gastelumosiel/active-6-band-audio-equalizer-pcb/images/prototype/pcb_cnc_final_version.jpg

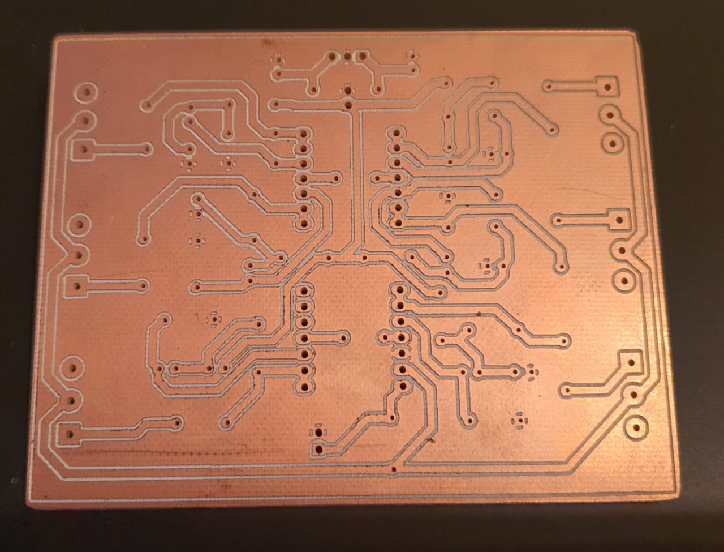
images/prototype/pcb_cnc_final_version.jpg
