gastelumosiel/active-6-band-audio-equalizer-pcb/images/prototype/pcb_cnc_3d_model.png

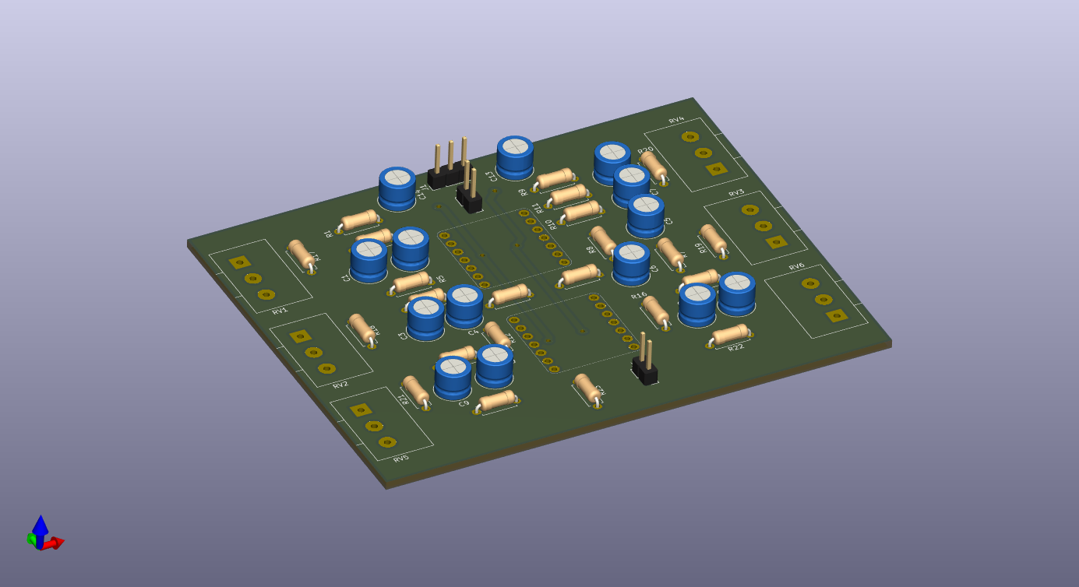
images/prototype/pcb_cnc_3d_model.png
