gastelumosiel/active-6-band-audio-equalizer-pcb/README.md

# active-6-band-audio-equalizer-pcb
Design, fabrication, and manufacturability analysis of a 4-layer PCB for a 6-band active audio equalizer using Sallen-Key filters and OPA4134 op-amps. Developed through an iterative approach from CNC-milled prototype to professional multilayer PCB in KiCad.
