gastelumosiel/active-6-band-audio-equalizer-pcb/prototype/results-report/Reporte_de_proyecto__Preamplificador_de_audio_activo.pdf

CENTRO DE ENSENANZA T ˜ | ECNICA Y SUPERIOR ´

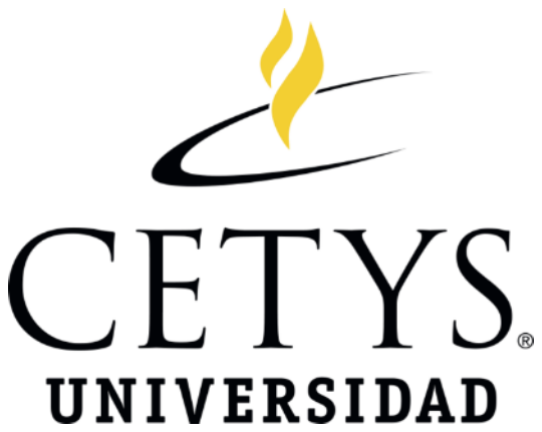
[picture p3: figure]

## Escuela de Ingeniería

Ingeniería en Cibernetica Electr ´ | onica ´
Diseno y fabricaci ˜ | on de circuitos integrados ´

## Reporte de proyecto: Preamplificador de audio activo de seis bandas

## Presentan: Osiel Gastelum Zazueta, 35596 ´ Rene Lozano García, 32827

## Tijuana, B.C., 20 de octubre de 2025

REPORTE DE AVANCE DE PROYECTO | 1

# Preamplificador de Audio Activo con Control de Seis Bandas

O. Gastelum Zazueta; R. Lozano Garcia ´

Resumen—En este trabajo se presenta el diseno y desarrollo ˜ de un preamplificador de audio activo basado en filtros de seis bandas de frecuencia. El sistema esta dise ´ nado para proporcionar ˜ control independiente sobre rangos de frecuencia específicos: pasa bajas (<60 Hz), y cuatro bandas intermedias (60-200 Hz, 200-600
Hz, 600-3 kHz, 3-12 kHz), ademas de un filtro pasa altas ( ´ | | >12
kHz). Se implementan topologías Sallen-Key de segundo orden con respuesta Butterworth para todas las bandas, utilizando
amplificadores operacionales de precision OPA4187. El dise ´ | | nõ
incluye una etapa de sumador amplificador con control individual de ganancia mediante potenciometros, seguido de un amplificador ´ inversor que funciona como control maestro de volumen. Se
presenta el proceso completo desde el diseno te ˜ | orico, simulaci ´ | on, ´
seleccion de componentes, hasta el dise ´ | no del circuito impreso ˜
(PCB), cumpliendo con las especificaciones de un area m ´ | axima ´
de 10cm x 10cm.

Index Terms—Preamplificador, filtros activos, Sallen-Key, Butterworth, ecualizador, amplificadores operacionales, PCB.

I. PROPUESTA DEL PROYECTO

I-A. Título
Preamplificador de Audio Activo con Control de Seis Bandas de Frecuencia

I-B. Introduccion´
E
l procesamiento de senales de audio ha sido fundamental ˜ en el desarrollo de sistemas de telecomunicaciones y entretenimiento desde sus inicios. Los ecualizadores y preamplificadores permiten manipular el contenido espectral de las senales de audio para mejorar su calidad, compensar ˜ deficiencias en la respuesta de transductores, o ajustar el sonido segun preferencias del usuario. ´
Los primeros dispositivos de ecualizacion eran sistemas ´ pasivos limitados que introducían perdidas significativas en ´
la senal. Con el desarrollo de la electr ˜ | onica de estado s ´ | olido ´
surgieron los ecualizadores activos, que incorporan amplificadores operacionales para no solo filtrar sino tambien amplificar ´ selectivamente las senales. Estos dispositivos han revoluciona- ˜ do la produccion musical, los sistemas de sonido profesional ´ y el audio de consumo.
Este proyecto se centra en el diseno e implementaci ˜ | on de un ´
preamplificador activo de seis bandas que divide el espectro audible en rangos específicos de frecuencia. El sistema permite control independiente de cada banda mediante potenciometros, ´ proporcionando flexibilidad para adaptar la respuesta de fre-
cuencia segun las necesidades de la aplicaci ´ | on. A trav ´ | es de ´
este desarrollo se exploran los fundamentos teoricos de los ´
filtros activos, los desafíos practicos del dise ´ | no de circuitos de ˜
audio, y la implementacion f ´ | ísica mediante un circuito impreso
profesional.

I-C. Planteamiento del Problema

En aplicaciones de audio profesional y de consumo, frecuentemente se requiere la capacidad de modificar selectivamente el contenido espectral de las senales de audio. Los sistemas ˜
de reproduccion, las caracter ´ | ísticas acusticas de los espacios, ´
y las preferencias individuales hacen necesario contar con herramientas que permitan ajustar la respuesta en frecuencia de manera controlada.
Los sistemas de ecualizacion pasiva introducen p ´ | erdidas ´
significativas y tienen limitaciones en cuanto a su capacidad de amplificacion. Por otro lado, los ecualizadores comerciales ´ pueden resultar costosos o no ofrecer la flexibilidad necesaria para aplicaciones específicas. Existe entonces la necesidad de desarrollar un sistema activo que proporcione control indepen-
diente sobre multiples bandas de frecuencia, dise ´ | no compacto ˜
y flexibilidad para ajuste en tiempo real.

I-D. Justificacion´

El desarrollo de este preamplificador activo se justifica por
multiples razones t ´ | ecnicas y educativas: ´
Aplicabilidad practica: ´ | El dispositivo puede ser utilizado
en sistemas de audio domesticos, estudios de grabaci ´ | on, sis- ´
temas de sonido en vivo, y aplicaciones de investigacion en ´ acustica. ´
Valor educativo: El proyecto integra conocimientos de
analisis de circuitos, procesamiento de se ´ | nales, dise ˜ | no de fil- ˜
tros activos, y fabricacion de PCB, proporcionando experiencia ´ practica en el ciclo completo de desarrollo de un producto ´ electronico. ´
Economía: El diseno propuesto utiliza componentes comer- ˜ ciales disponibles a costos accesibles, resultando en un sistema
considerablemente mas econ ´ | omico que equipos comerciales ´
equivalentes.
Flexibilidad: A diferencia de sistemas comerciales fijos, es-
te diseno permite modificaciones y ajustes seg ˜ | un necesidades ´
específicas, facilitando su adaptacion a diferentes aplicaciones. ´

I-E. Objetivo

Objetivo General: Disenar, implementar y validar un ˜ preamplificador de audio activo de seis bandas con control independiente de ganancia, utilizando filtros Sallen-Key de segundo orden y amplificadores operacionales de precision. ´ Objetivos Específicos:
Disenar filtros activos Sallen-Key con respuesta Butter- ˜ worth para cada una de las seis bandas de frecuencia especificadas

Calcular y seleccionar los valores de componentes pasivos (resistores y capacitores) para lograr las frecuencias de corte deseadas
Implementar una etapa de sumador amplificador con control individual de ganancia para cada banda Seleccionar componentes apropiados considerando tolerancias, disponibilidad y encapsulados through-hole Desarrollar el esquematico el ´ ectrico completo del sistema ´ Disenar el circuito impreso (PCB) cumpliendo con las ˜ restricciones dimensionales establecidas
Generar los archivos Gerber y de perforacion necesarios ´ para la fabricacion´
Realizar un prototipado rapido como demostraci ´ | on del ´
anteproyecto

I-F. Marco teorico ´
I-F1. Filtros Activos: Segun Alexander y Sadiku [1], ´
un filtro es un circuito electrico cuya funci ´ | on principal es ´
la modificacion o manipulaci ´ | on del espectro en frecuencias ´
de una senal de entrada. Los filtros activos, a diferencia ˜ de sus contrapartes pasivas, utilizan elementos activos como amplificadores operacionales junto con componentes pasivos, permitiendo no solo el filtrado selectivo de frecuencias sino
tambien la amplificaci ´ | on de la se ´ | nal. ˜
Como mencionan Dorf y Svoboda [2], estos circuitos tienen
la capacidad de eliminar de una senal el ˜ | ectrica elementos no ´
deseados como el ruido electrico, adem ´ | as de proporcionar ´
ganancia sin las perdidas inherentes a los filtros pasivos. El ´
termino respuesta en frecuencia describe c ´ | omo un circuito ´
particular afecta a la senal que pasa a trav ˜ | es de ´ | el, ya sea ´
amplificando o atenuando frecuencias específicas.
Los filtros activos presentan ventajas significativas sobre los pasivos:
Capacidad de amplificacion de la se ´ | nal ˜
Alta impedancia de entrada
Baja impedancia de salida
No requieren inductores (componentes voluminosos y costosos)
Mayor flexibilidad en el disenõ
Mejor control sobre la respuesta en frecuencia
I-F2. Topología Sallen-Key: La topología Sallen-Key, tambien conocida como fuente de voltaje controlada por volta- ´ je (VCVS), es una de las configuraciones mas populares para ´ implementar filtros activos de segundo orden. Esta topología, desarrollada por R.P. Sallen y E.L. Key en 1955 [11], ofrece varias ventajas:
Requiere solo un amplificador operacional por seccion´ de segundo orden
Utiliza unicamente capacitores y resistores como elemen- ´ tos pasivos
Proporciona baja impedancia de salida
Permite implementar diferentes tipos de respuesta (Butterworth, Bessel, Chebyshev)
Facilita el diseno en cascada para ˜ | ordenes superiores ´
I-F3. Respuesta Butterworth: Segun Torres De Roa [6], ´ el filtro Butterworth ofrece el mejor termino medio entre ´ la atenuacion y la respuesta en fase, proporcionando una ´ transicion suave entre la banda pasante y la banda de rechazo. ´ Su característica principal es una respuesta maximamente ´ plana en la banda util, garantizando que no haya ondulaciones ´ que distorsionen la senal. ˜
Para aplicaciones de audio, la respuesta Butterworth es particularmente adecuada porque:

Minimiza la distorsion de fase en la banda pasante ´ Proporciona una transicion predecible entre bandas ´ Ofrece características de fase superiores comparadas con Chebyshev
Resulta en un sonido mas natural sin coloraci ´ | on excesiva ´
I-F4. Amplificadores Operacionales de Precision: ´ | El
OPA4187 es un amplificador operacional de precision que ´ ofrece bajo ruido, bajo offset y alta velocidad de slew rate, características esenciales para aplicaciones de audio de alta calidad [9]. Con cuatro amplificadores por circuito integrado,
proporciona una solucion compacta y econ ´ | omica para el ´
diseno propuesto. ˜

I-G. Metodología

El desarrollo del proyecto sigue una metodología estructura-
da que abarca desde el diseno te ˜ | orico hasta la implementaci ´ | on´
física:
I-G1. Fase 1: Diseno Te ˜ | orico y Simulaci ´ | on: ´
1. Especificacion de requisitos: ´
Definicion de bandas de frecuencia ´ Especificacion de orden de filtros ´
Seleccion de tipo de respuesta (Butterworth) ´ Definicion de rangos de ganancia ´
2. Calculo de componentes: ´
Utilizacion de herramienta de dise ´ | no de filtros de ˜
Texas Instruments (WEBENCH Filter Designer) Seleccion de valores comerciales de la serie E96 ´ (resistores 1 %) y E12 (capacitores 10 %)
I-G2. Fase 2: Diseno Electr ˜ | | onico: ´
1. Desarrollo del esquematico: ´
Diagramacion completa del circuito en KiCAD ´ Inclusion de todos los componentes y conexiones ´ Asignacion de valores y referencias ´
Verificacion de conectividad mediante DRC (De- ´ sign Rule Check)
2. Seleccion de componentes: ´
Identificacion | de | footprints | espec ´ | íficos | para
through-hole
Descarga de footprints y modelos 3D
Justificacion t ´ | ecnica de cada selecci ´ | on basada en ´
hojas de datos
3. Lista de materiales (BOM):
Compilacion de todos los componentes ´
Especificacion de n ´ | umeros de parte ´
Cantidades requeridas
Descripcion t ´ ecnica de cada componente ´

I-G3. Fase 3: Diseno del PCB: ˜
1. Layout del PCB:
Colocacion estrat ´ | egica de componentes ´
Ruteo de pistas considerando:
- Minimizacion de ruido e interferencias ´
- Separacion de se ´ | nales anal ˜ | ogicas y digitales ´
- Longitud de pistas críticas
- Ancho de pistas segun corriente ´ Implementacion de planos de tierra ´
Ubicacion de puntos de montaje ´
2. Verificacion del dise ´ | no: ˜
Verificacion de reglas de dise ´ | | no (DRC) ˜
Verificacion el ´ | ectrica (ERC) ´
Revision dimensional ( ´ | | ≤ 100 mm x 100 mm)
Verificacion de clearances y espaciamientos ´
3. Generacion de archivos de fabricaci ´ | on: ´
Archivos Gerber
Archivos de perforacion´
Dibujo de fabricacion con notas especiales ´
Exportacion del esquem ´ | atico en PDF ´

II. DISENÕ ELECTRICO ´

II-A. Arquitectura General del Sistema
El preamplificador propuesto consta de dos etapas principales:
1. Etapa de filtrado: Seis filtros activos independientes que dividen la senal de entrada en las bandas especifi- ˜ cadas
2. Etapa de sumador amplificador: Combina las senales ˜ filtradas con control de ganancia individual para cada banda

II-B. Especificaciones de las Bandas de Frecuencia
La Tabla I presenta las especificaciones completas de cada banda, incluyendo el tipo de filtro, rango de frecuencia, considerando que todos son de topología Sallen-Key, de segundo orden y con una respuesta Butterworth.

Cuadro I
ESPECIFICACIONES DE BANDAS DE FRECUENCIA
Banda | Tipo | Rango
1 | Pasa bajas | < 60 Hz
2 | Pasa bandas | 60-200 Hz
3 | Pasa bandas | 200-600 Hz
4 | Pasa bandas | 600-3k Hz
5 | Pasa bandas | 3-12k Hz
6 | Pasa altas | > 12 kHz

II-C. Diseno de Filtros Sallen-Key ˜
Para el diseno de los filtros activos se utiliz ˜ | o la herramienta ´
WEBENCH Filter Designer de Texas Instruments [10]. Esta
herramienta permite el calculo autom ´ | atico de valores de com- ´
ponentes para filtros Sallen-Key con respuesta Butterworth, considerando las especificaciones de frecuencias de corte y factor de calidad Q requeridos. Los valores finales de componentes se presentan a continuacion basados en el archivo ´ Excel proporcionado.
El filtro pasa bajas de segundo orden se implementa mediante la configuracion Sallen-Key con frecuencia de corte de 60 ´ Hz y factor de calidad Q = 0.707 (característico de respuesta Butterworth de segundo orden).
Los filtros pasa bandas se disenaron especificando las ˜ frecuencias de corte inferior y superior para cada banda. La herramienta calcula automaticamente la frecuencia central ´ fc =

√
fL · fH y el factor de calidad Q =

fc
BW necesarios
para la implementacion Sallen-Key. ´
El filtro pasa altas de segundo orden utiliza frecuencia de corte de 12 kHz con Q = 0.707.

II-D. Etapa de Sumador Amplificador
La etapa sumadora combina las seis senales filtradas me- ˜ diante un amplificador operacional en configuracion de su- ´ mador inversor. Para proporcionar control individual de cada
banda, se utilizan potenciometros de 20 k ´ | | | Ω como resistencias
de entrada para cada canal, con un resistor de 1 kΩ en serie como limitador.
Con los valores de cada fase específicados en la tabla II, la ganancia por banda es ajustable, proporcionando un rango de control adecuado para aplicaciones de audio.

II-E. Seleccion de Componentes ´
II-E1. Amplificadores Operacionales: Se selecciono el ´ OPA4187 de Texas Instruments como amplificador operacional principal [9]:
Justificacion t ´ ecnica: ´
Bajo ruido: 3.2 nV/√
Hz @ 1 kHz (crítico para audio) Alto CMRR: 120 dB típico
Bajo offset: ±25 µV maximo ´
Ancho de banda: 15 MHz (suficiente para audio)
Slew rate: 8 V/µs (adecuado para senales de audio) ˜ Cuatro amplificadores por IC (economía y compacidad) Alimentacion: ±2.25 V a ±18 V ´
Cantidad requerida:
6 filtros (6 amplificadores)
1 sumador (1 amplificador)
Total: 7 amplificadores = 2 IC OPA4187
II-E2. Resistores: Especificacion: ´ Serie E96, tolerancia
1 %, potencia 1/4 W, montaje through-hole (THT), footprint
R_Axial_DIN0207_L6.3mm_D2.5mm_P7.62mm_Horizontal
II-E3. Capacitores: Especificacion: ´ | Serie E12, tolerancia
10 %, tipo ceramico/radial, ´ | montaje through-hole (THT),
footprint C_Radial_D6.3mm_H5.0mm_P2.50mm
II-E4. Potenciometros: ´ | Especificacion: ´ | Tipo vertical para
PCB, 20 kΩ, lineal (tipo B)
Cantidad requerida:
6 potenciometros para control individual de bandas ´
Total: 6 potenciometros de 20 k ´ | Ω
II-E5. Conectores: Entrada de senal: ˜ | Conector Jack 3.5
mm mono o estereo (selecci ´ | on seg ´ | un aplicaci ´ | on) ´
Salida de senal: ˜ | Conector Jack 3.5 mm mono o estereo ´
Alimentacion: ´ | Conector de 3 pines para fuente dual (V+,
GND, V-)

II-F. Lista de Materiales

La Tabla II presenta la lista completa de materiales (BOM) con símbolos correspondientes al diagrama esquematico. ´

Cuadro II
LISTA DE MATERIALES (BOM)
Símbolo | Descripcion´ | Cantidad
| Pasa Bajas (Banda 1)
R1 | Resistor 1.3 k, 1 %, 1/4W, THT | 1
R2 | Resistor 2.49 k, 1 %, 1/4W, THT | 1
C1 | Capacitor 1 F, radial, THT | 1
C2 | Capacitor 2.2 F, radial, THT | 1
| Pasa Bandas 1 (Banda 2)
R3 | Resistor 11.3 k, 1 %, 1/4W, THT | 1
R4 | Resistor 205 , 1 %, 1/4W, THT | 1
R5 | Resistor 1.05 M, 1 %, 1/4W, THT | 1
C3 | Capacitor 100 nF, radial, THT | 1
C4 | Capacitor 100 nF, radial, THT | 1
| Pasa Bandas 2 (Banda 3)
R6 | Resistor 4.02 k, 1 %, 1/4W, THT | 1
R7 | Resistor 66.5 , 1 %, 1/4W, THT | 1
R8 | Resistor 324 k, 1 %, 1/4W, THT | 1
C5 | Capacitor 100 nF, radial, THT | 1
C6 | Capacitor 100 nF, radial, THT | 1
| Pasa Bandas 3 (Banda 4)
R9 | Resistor 6.65 k, 1 %, 1/4W, THT | 1
R10 | Resistor 169 , 1 %, 1/4W, THT | 1
R11 | Resistor 845 k, 1 %, 1/4W, THT | 1
C7 | Capacitor 10 nF, radial, THT | 1
C8 | Capacitor 10 nF, radial, THT | 1
| Pasa Bandas 4 (Banda 5)
R12 | Resistor 1.78 k, 1 %, 1/4W, THT | 1
R13 | Resistor 37.4 k, 1 %, 1/4W, THT | 1
R14 | Resistor 191 k, 1 %, 1/4W, THT | 1
C9 | Capacitor 10 nF, radial, THT | 1
C10 | Capacitor 10 nF, radial, THT | 1
| Pasa Altas (Banda 6)
R15 | Resistor 13.3 k, 1 %, 1/4W, THT | 1
R16 | Resistor 6.49 k, 1 %, 1/4W, THT | 1
C11 | Capacitor 1.8 nF, radial, THT | 1
C12 | Capacitor 1.2 nF, radial, THT | 1
| Amplificador Sumador
RV1-RV6 | Potenciometro 20 k lineal ´ | 6
R17-R22 | Resistor 1 k, 1 %, 1/4W, THT | 6
R23 | Resistor realimentacion sumador ´ | 1
| Componentes Activos
U1, U2 | IC Op-Amp OPA4187 | 2
III. DISENO DEL ˜ | CIRCUITO IMPRESO (PCB)

III-A. Consideraciones de Disenõ

El diseno del PCB para un preamplificador de audio requiere ˜ consideraciones especiales para minimizar ruido, interferencias y distorsion: ´
III-A1. Estrategia de Layout:
Separacion de etapas: ´ | Las seis bandas de filtrado se
organizan en dos grupos paralelos para optimizar el espacio
Flujo de senal: ˜ Layout disenado siguiendo el flujo ˜ natural de la senal desde la entrada, pasando por los ˜ filtros, el sumador y finalmente el amplificador maestro hasta la salida

Plano de tierra: Implementacion de plano de tierra ´ continuo en la capa inferior para minimizar impedancia y proporcionar blindaje
III-A2. Ruteo de Pistas:
Ancho de pistas: 1 mm (suficiente para senales de audio ˜ de bajo nivel)
Clearance mínimo: 0.254 mm
Longitud de pistas críticas: Minimizada entre entrada de amplificadores operacionales y componentes pasivos Pistas de entrada/salida: Alejadas de pistas de alimentacion para minimizar acoplamiento capacitivo ´
III-A3. Ubicacion de Componentes: ´
Capacitores de desacoplo: Ubicados lo mas cerca po- ´ sible de los pines de alimentacion´
Componentes de filtro: Agrupados por banda para minimizar longitud de interconexiones
Potenciometros: ´ | Ubicados en el borde del PCB para
facilitar acceso y manipulacion´
Conectores: Posicionados en bordes opuestos (entrada en un lado, salida en otro) para evitar acoplamiento
III-A4. Tecnicas de Reducci ´ | on de Ruido: ´
Estrellado de tierras: Punto de conexion´ | unico para ´
todas las tierras analogicas ´
Zonas de tierra: Pistas de tierra rodeando senales cr ˜ | íti-
cas

III-B. Especificaciones del PCB
Dimensiones: Dentro del límite de 10 cm × 10 cm
Numero de capas: ´ | 2 capas (superior: componentes y
senal, inferior: pistas de alimentaci ˜ | on y tierra) ´
Espesor del PCB: 1.6 mm (estandar) ´
Serigrafía: Blanca en capa superior (referencias de componentes, logos, informacion) ´
Material: FR-4 (estandar) ´
Espesor del cobre: 1 oz (35 µm)
III-C. Esquematico El ´ | ectrico ´

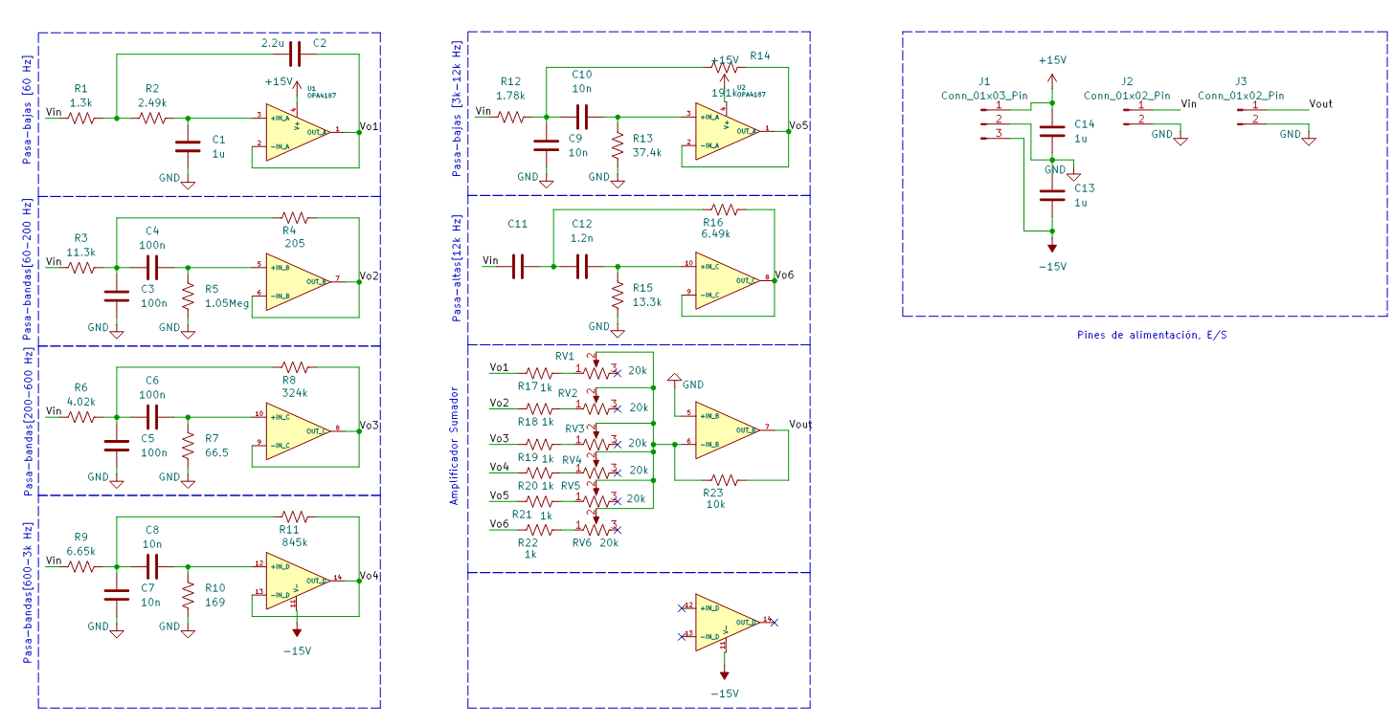
[picture p4: figure]

Figura 1. Esquematico el ´ | ectrico completo del preamplificador de audio activo. ´
Se muestran las seis etapas de filtrado, la etapa sumadora y la etapa maestra de amplificacion. ´

El esquematico completo del circuito se presenta en la ´ Figura 1. El diagrama incluye todas las conexiones electri- ´ cas, valores de componentes actualizados segun el Excel, y ´ referencias necesarias para la implementacion del circuito. ´

III-D. Layout del PCB

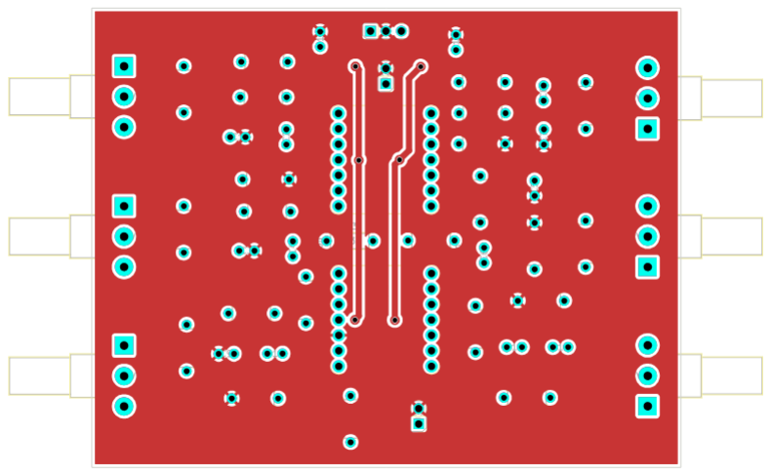
[picture p5: figure]

Figura 2. Vista de la capa superior del PCB mostrando el ruteo de senales, ˜
ubicacion de componentes THT, y colocaci ´ | on de potenci ´ | ometros y conectores. ´

III-D1. Capa Superior (Top Layer): La Figura 2 muestra la capa superior del PCB donde se ubican todos los componentes through-hole y la mayoría del ruteo de senales. Se puede ˜ observar:
Distribucion sim ´ | etrica de las seis etapas de filtrado ´
Ubicacion estrat ´ | egica de los potenci ´ | ometros en el borde ´
superior para facil acceso ´
Conectores de entrada y salida en bordes opuestos Capacitores de desacoplo cercanos a cada IC Serigrafía con referencias de componentes

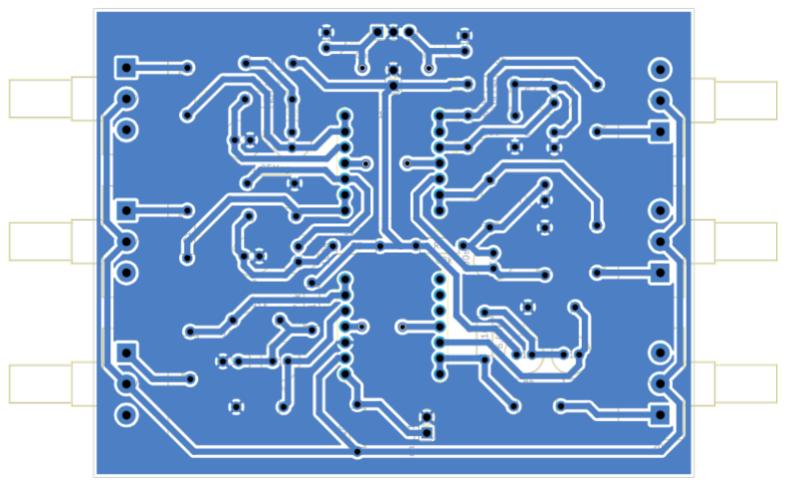
[picture p6: figure]

Figura 3. Vista de la capa inferior del PCB mostrando el plano de tierra continuo y conexiones de alimentacion. ´

III-D2. Capa Inferior (Bottom Layer): La capa inferior (Figura 3) esta mayormente dedicada al plano de tierra, ´ proporcionando:
Referencia comun de baja impedancia para todas las ´ senales ˜
Blindaje contra interferencias electromagneticas ´
Camino de retorno de corriente optimo ´
Distribucion eficiente de alimentaci ´ | on´
III-D3. Vista 3D del PCB: El modelo 3D (Figura 4) proporciona una visualizacion realista del producto final, per- ´ mitiendo verificar:

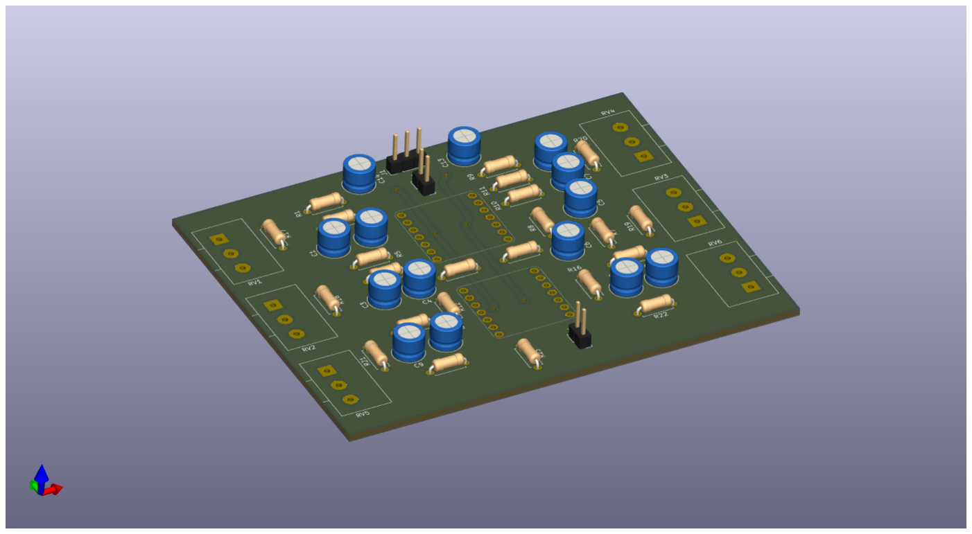
[picture p7: figure]

Figura 4. Modelo 3D del PCB ensamblado mostrando componentes THT, potenciometros y conectores. ´

Altura total del ensamble con componentes through-hole Interferencias mecanicas potenciales ´
Accesibilidad de controles
Aspecto estetico del dise ´ | nõ
III-E. Verificacion del Dise ´ | nõ

III-E1. Design Rule Check (DRC):
Verificacion de espaciamientos m ´ | | ínimos entre pistas
Verificacion de ancho m ´ | | ínimo de pistas
Verificacion de tama ´ | no de v ˜ | ías y perforaciones para
componentes THT
Verificacion de zonas de cobre y clearances ´
Resultado: 0 errores, 0 advertencias

III-E2. Electrical Rule Check (ERC):
Verificacion de conectividad el ´ | | ectrica ´
Deteccion de nodos flotantes ´
Verificacion de alimentaci ´ | on de todos los componentes ´
Deteccion de cortocircuitos ´
Resultado: 0 errores, advertencias menores resueltas

III-E3. Verificacion Dimensional: ´
Area total: ´ | < 100 cm²
Clearance a bordes
Ubicacion de perforaciones de montaje ´
Espacio suficiente para componentes through-hole (altura adecuada)
III-F. Generacion de Archivos de Fabricaci ´ | on´

III-F1. Archivos Gerber (RS-274X): Los siguientes archi-
vos Gerber fueron generados segun el formato est ´ | andar RS- ´
274X [13]:

PCB_ProyectoParte_1-F_Cu.gbr: Capa superior
de cobre
PCB_ProyectoParte_1-B_Cu.gbr: Capa inferior
de cobre (plano de tierra)
PCB_ProyectoParte_1-B_SilkS.gbr: Serigrafía
inferior
PCB_ProyectoParte_1-Edge_Cuts.gbr: Con-
torno del PCB

III-F2. Archivos de Perforacion (Excellon): ´

PCB_ProyectoParte_1.drl: Archivo de perfora-
ciones
Especificaciones de perforacion: ´
Perforaciones de componentes THT (resistores, capacitores): 0.8-1.0 mm
Perforaciones de potenciometros: 1.0-1.2 mm ´ Perforaciones de conectores: segun especificaciones del ´ fabricante

IV. RESULTADOS PRELIMINARES

IV-A. Simulacion del Dise ´ | nõ
Aunque la simulacion completa del circuito est ´ | a pendiente ´
de realizarse con el software apropiado (LTspice o similar), se han verificado los siguientes aspectos teoricos: ´
IV-A1. Respuesta en Frecuencia Calculada: Para cada banda, se verificaron las frecuencias de corte teoricas basadas ´ en los valores de componentes del Excel:

Cuadro III
BANDAS DE FRECUENCIA CON VALORES ACTUALIZADOS
Banda | Tipo | Rango objetivo
1 | Pasa bajas | <60 Hz
2 | Pasa bandas | 60-200 Hz
3 | Pasa bandas | 200-600 Hz
4 | Pasa bandas | 600-3k Hz
5 | Pasa bandas | 3-12k Hz
6 | Pasa altas | >12k Hz
IV-A2. Analisis de Tolerancias: ´ | Considerando el peor caso
(worst-case analysis) con tolerancias de componentes: Resistores: ±1 %
Capacitores: ±10 %
Variacion total esperada en ´ | fc: Aproximadamente
±11 %
Esta variacion es aceptable para aplicaciones de audio, ´ donde las bandas adyacentes proporcionan cobertura de solapamiento.
IV-A3. Analisis de Ganancia: ´ | Para la etapa de sumador
con potenciometros de 20 k ´ | Ω, el rango de ganancia por banda
es ajustable segun los valores de resistores de realimentaci ´ | on´
implementados.
IV-B. Verificacion del Dise ´ | no del PCB ˜
IV-B1. Analisis de Integridad de Se ´ | nal: ˜ | Se verificaron
manualmente los siguientes aspectos:
Longitud de pistas críticas: Todas las pistas entre entradas de op-amps y componentes pasivos minimizadas Acoplamiento de pistas: Separacion adecuada entre ´ pistas paralelas de senal ˜
Loops de tierra: Minimizados mediante plano de tierra continuo
Retorno de corriente: Plano de tierra proporciona camino de baja impedancia

IV-B2. Fresado: El primer intento de fresado de la placa fenolica fue un proceso bastante ilustrativo del funcionamiento ´ de los sistemas que controlan las brocas y su posicion en los ´ ejes X, Y, y Z. En los trazos hechos por la broca de grabado en figura V, fue posible observar un ligero desacuerdo entre la vision original y el resultado del archivo G-Code. ´

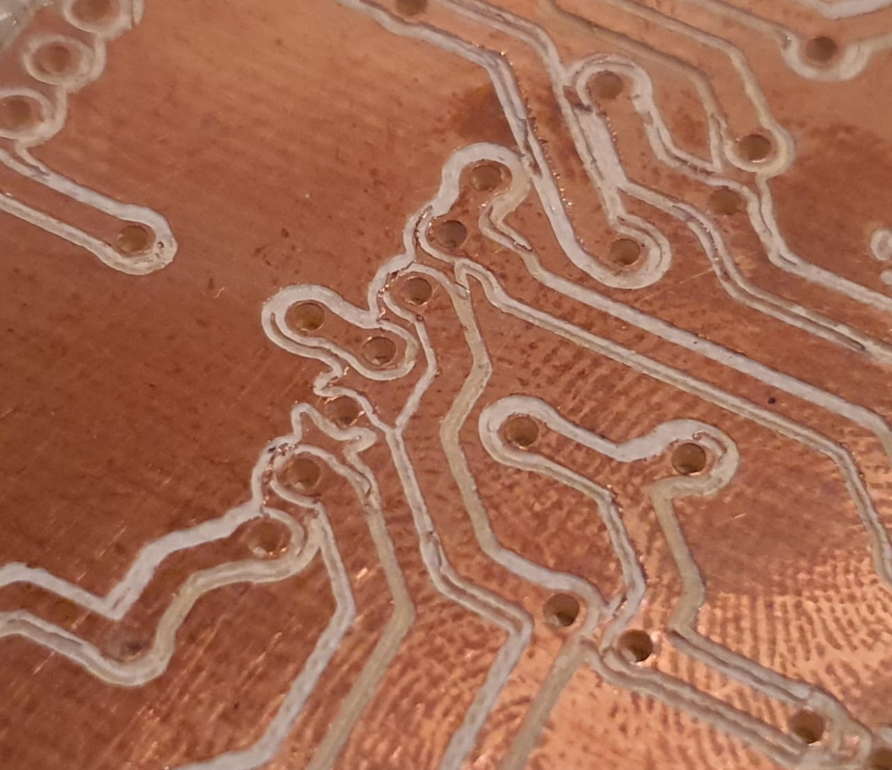
[picture p8: figure]

Figura 5. Primer intento de fresado, con errores en el codigo. ´

Al observar este resultado, se tomo un mayor cuidado en ´ el procedimiento de generacion de archivos, partiendo de ´ los Gerber en FlatCAM. Se realizaron modificaciones a las configuraciones para realizar un mejor trabajo en el siguiente intento.


Figura 6. Circuito impreso en su version final ´

IV-C. Archivos Generados

El proyecto completo en KiCAD incluye los siguientes archivos principales:

1. PCB_ProyectoParte_1.kicad_pro: Archivo de
proyecto
2. PCB_ProyectoParte_1.kicad_sch: Esquemati- ´
co electrico ´
3. PCB_ProyectoParte_1.kicad_pcb: Layout del
PCB
4. Carpeta gerber/: Archivos Gerber y de perforacion´
5. PCB_ProyectoParte_1_fabrication_drawing.pdf:
Dibujo de fabricacion´
6. PCB_ProyectoParte_1_schematic.pdf:
Esquematico en PDF ´
Todos los archivos estan organizados y comprimidos en ´ formato ZIP para entrega.
V. CONCLUSIONES
En este trabajo se ha completado exitosamente el disenõ completo de un preamplificador de audio activo de seis bandas, cumpliendo con todos los objetivos establecidos para esta fase del proyecto.

V-A. Logros del Avance
1. Diseno te ˜ | orico completo: ´ | Se disenaron todos los filtros ˜
para las seis bandas de frecuencia utilizando valores de componentes through-hole especificados, garantizando respuesta Butterworth y frecuencias de corte precisas.
2. Seleccion de componentes: ´ | Se identificaron y espe-
cificaron todos los componentes necesarios en version through-hole, incluyendo footprints apropiados ´
(R_Axial_DIN0207 y C_Radial_D6.3mm) y jus-
tificacion t ´ | ecnica basada en hojas de datos. ´
3. Esquematico el ´ | ectrico: ´ | Se desarrollo el diagrama ´
electrico completo en KiCAD, verificado mediante DRC ´ y ERC sin errores.
4. Diseno del PCB: ˜ | Se completo el layout del circuito ´
impreso cumpliendo con las restricciones dimensionales y aplicando las mejores practicas para circuitos de audio ´ con componentes THT.
5. Documentacion de fabricaci ´ | on: ´ | Se generaron todos
los archivos necesarios para la fabricacion profesional ´ del PCB, incluyendo archivos Gerber, archivos de per-
foracion y dibujo de fabricaci ´ | on con especificaciones ´
completas.

V-B. Analisis de Viabilidad ´
El diseno propuesto es t ˜ | ecnicamente viable y presenta las ´
siguientes fortalezas:
Componentes disponibles: Todos los componentes THT especificados estan disponibles comercialmente de pro- ´ veedores como Digi-Key, Mouser y otros distribuidores autorizados.
Fabricacion est ´ | andar: ´ | El PCB utiliza especificaciones
estandar de la industria (2 capas, FR-4) compatible con ´
servicios de fabricacion econ ´ | omicos (JLCPCB, PCBWay, ´
etc.).
Facilidad de ensamble: Los componentes through-hole facilitan el proceso de soldadura manual y permiten inspeccion visual directa de las conexiones. ´

V-C. Trabajo Futuro
Para la segunda fase del proyecto (implementacion y prue- ´ bas), se planean las siguientes actividades:
1. Simulacion completa: ´
Analisis AC de cada banda en LTspice ´
Analisis de transitorios ´
Analisis de distorsi ´ | on arm ´ | onica (THD) ´
Analisis de ruido ´
2. Fabricacion del PCB: ´
Seleccion del fabricante ´
Cambio de diseno a componentes SMT ˜ Envío de archivos Gerber
Recepcion y verificaci ´ | on de PCBs ´
3. Adquisicion de componentes: ´
Generacion de orden de compra ´ Compra de componentes through-hole Inspeccion al recibir ´
4. Ensamble:
Soldadura de componentes SMT
Inspeccion visual y el ´ | ectrica ´
5. Pruebas y caracterizacion: ´
Pruebas de continuidad
Verificacion de alimentaci ´ | | on´
Medicion de respuesta en frecuencia ´
Medicion de ganancia y rango de control ´ Documentacion de resultados ´
El proyecto esta bien encaminado para su conclusi ´ | on exitosa ´
en la segunda fase, con expectativas realistas de obtener un producto funcional que cumpla con las especificaciones de diseno. ˜

REFERENCIAS

[1] C. K. Alexander and M. N. O. Sadiku, Fundamentos de Circuitos
Electricos ´ | , 5ta ed. McGraw-Hill, 2013.
[2] R. C. Dorf y J. A. Svoboda, Circuitos Electricos ´ | , Alfaomega, 2011.
[3] J. Fraile, Circuitos Electricos ´ | , Pearson, 2012.
[4] W. Hayt, J. Kemmerly, J. Phillips y S. Durbin, Analisis de Circuitos en ´ Ingeniería, 9na ed., McGraw Hill, 2019.
[5] J. M. Fiore, Operational Amplifiers & Linear Integrated Circuits: Theory and Application, 3rd ed., Dissidents, 2024.
[6] L. D. Torres De Roa, Realizacion Activa en Matlab ´ | , Universidad de las
Americas Puebla, 2007. ´
[7] D. Madrid, Implementacion de Filtros Pasa Baja: Bessel y Chebyshev ´ | ,
ResearchGate, 2017.
[8] Universidad Nacional de Tucuman, ´ Filtros, 2017. Disponible en: https: //catedras.facet.unt.edu.ar/e1/
[9] Texas Instruments, OPA4187 36-V, Precision, Low-Noise, Rail-to-Rail Output, JFET Operational Amplifier, Datasheet, 2021.
[10] Texas Instruments, WEBENCH Filter Designer, 2024. Disponible
en: | https://www.ti.com/design-resources/design-tools-simulation/
webench-power-designer.html (https://www.ti.com/design-resources/design-tools-simulation/webench-power-designer.html)
[11] R. P. Sallen and E. L. Key, A Practical Method of Designing RC Active Filters, IRE Transactions on Circuit Theory, vol. CT-2, pp. 74-85, 1955.
[12] KiCAD EDA, KiCAD Documentation, Version 9.0, 2024. Disponible en: https://docs.kicad.org/
[13] IPC, IPC-2221B: Generic Standard on Printed Board Design, IPC International, 2012.
