gastelumosiel/active-6-band-audio-equalizer-pcb/docs/BOM.xlsx

Sheet: BOM
 |  |  |  |  |  |  |  |  |  |  | No de PCBs | 2
Bloque de alimentación |  | BOM
 |  | Componente | Valor | Rating | Tipo de montura | Footprint | Referencia | Digikey Num | Datasheets | Precio c/u | Cantidad (uni) | P. Comp. | Subtotal (2) | P. EXT
 |  | Charge pump regulator |  |  | SMT |  | TC962COE | TC962COE-ND | Link (https://ww1.microchip.com/downloads/aemDocuments/documents/APID/ProductDocuments/DataSheets/21484D.pdf) | $3.92 | 1 | $3.92 | 2 | $7.84
 |  | Barrel DC |  |  | SMT |  | PJ-114AH-SMT-TR | 2223-PJ-114AH-SMT-TRCT-ND | Link (https://www.kycon.com/Pub_Eng_Draw/KLDVX-SMT-02-B.pdf) | $0.84 | 1 | $0.84 | 2 | $1.68
 |  | Regulador 15 V |  | 15 V, 1.5 A | SMT |  | L7815CD2T-TR | 497-1179-1-ND | Link (https://www.st.com/content/ccc/resource/technical/document/datasheet/41/4f/b3/b0/12/d4/47/88/CD00000444.pdf/files/CD00000444.pdf/jcr:content/translations/en.C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) | $0.90 | 1 | $0.90 | 2 | $1.80
 |  | CA1 | 0.33 uF | 5%, 50 V | SMT | 0805 | C0805C334J5RECAUTO | 399-C0805C334J5RECAUTOCT-ND |  | $0.28 | 1 | $0.28 | 2 | $0.56
 |  | CA2 | 0.1 uF | 5%, 50V | SMT | 0805 | C0805C104J5RACTU | 399-C0805C104J5RACTUCT-ND | Link (https://www.yageogroup.com/content/datasheet/asset/file/KEM_C1002_X7R_SMD) | $0.15 | 1 | $0.15 | 2 | $0.30
 |  | CA3 a CA4 | 10 uF | 10%, 20 V | SMT | 1206 (3216 Metric) | T491A106K020AT | 399-18019-1-ND | Link (https://www.yageogroup.com/content/datasheet/asset/file/KEM_T2004_T490) | $0.60 | 2 | $1.20 | 3 | $1.80
 |  | CA5 | 1 uF | 10%, 20 V | SMT | 1206 (3216 Metric) | TPSA105K020R3000 | 478-2399-1-ND | Link (https://datasheets.kyocera-avx.com/TPS.pdf) | $0.63 | 1 | $0.63 | 2 | $1.26
Bloque de señal de entrada |  | Jack Mono 3.5 mm |  |  | SMT |  | MJ-3523-SMT-TR | CP-3523MJCT-ND | Link (https://www.sameskydevices.com/product/resource/mj-3523-smt.pdf) | $0.92 | 2 | $1.84 | 3 | $2.76
Bloque de preamplificación | Pasa bajas | R1 | 1.3 kΩ | 1%, 0.125W | SMT | 0805 | RMCF0805FT1K30 | RMCF0805FT1K30CT-ND | Link (https://www.seielect.com/catalog/SEI-RMCF_RMCP.pdf) | $0.10 | 1 | $0.10 | 3 | $0.30
 |  | R2 | 2.49 kΩ | 1%, 0.125W | SMT | 0805 | RC0805FR-072K49L | 311-2.49KCRCT-ND | Link (https://www.yageogroup.com/content/datasheet/asset/file/PYU-RC_GROUP_51_ROHS_L) | $0.10 | 1 | $0.10 | 3 | $0.30
 |  | C1 | 1 uF | 5%, 50V | SMT | 0805 | CC0805JKX7R9BB105 | 311-3498-1-ND | Link (https://www.yageogroup.com/content/datasheet/asset/file/UPY-GPHC_X7R_6_3V-TO-250V) | $0.29 | 1 | $0.29 | 2 | $0.58
 |  | C2 | 2.2 uF | 5%, 25V | SMT | 0805 | CC0805JKX7R8BB225 | 13-CC0805JKX7R8BB225CT-ND | Link (https://www.yageogroup.com/content/datasheet/asset/file/UPY-GPHC_X7R_6_3V-TO-250V) | $0.25 | 1 | $0.25 | 2 | $0.50
 | Pasa bandas 1 | R3 | 11.3 kΩ | 1%, 0.125W | SMT | 0805 | RC0805FR-0711K3L | 311-11.3KCRCT-ND | Link (https://www.yageogroup.com/content/datasheet/asset/file/PYU-RC_GROUP_51_ROHS_L) | $0.10 | 1 | $0.10 | 3 | $0.30
 |  | R4 | 205 Ω | 1%, 0.125W | SMT | 0805 | RC0805FR-07205RL | 311-205CRCT-ND | Link (https://www.yageogroup.com/content/datasheet/asset/file/PYU-RC_GROUP_51_ROHS_L) | $0.10 | 1 | $0.10 | 3 | $0.30
 |  | R5 | 1.05 MΩ | 1%, 0.125W | SMT | 0805 | RC0805FR-071M05L | 311-1.05MCRCT-ND | Link (https://www.yageogroup.com/content/datasheet/asset/file/PYU-RC_GROUP_51_ROHS_L) | $0.10 | 1 | $0.10 | 3 | $0.30
 |  | C3 a C4 | 100 nF | 5%, 50V | SMT | 805 | C0805C104J5RACTU | 399-C0805C104J5RACTUCT-ND | Link (https://www.yageogroup.com/content/datasheet/asset/file/KEM_C1002_X7R_SMD) | $0.15 | 2 | $0.30 | 3 | $0.45
 | Pasa bandas 2 | R6 | 4.02 kΩ | 1%, 0.125W | SMT | 0805 | RMCF0805FT4K02 | RMCF0805FT4K02CT-ND | Link (https://www.seielect.com/catalog/SEI-RMCF_RMCP.pdf) | $0.10 | 1 | $0.10 | 3 | $0.30
 |  | R7 | 66.5 Ω | 1%, 0.125W | SMT | 0805 | RMCF0805FT66R5 | 738-RMCF0805FT66R5CT-ND | Link (https://www.seielect.com/catalog/SEI-RMCF_RMCP.pdf) | $0.10 | 1 | $0.10 | 3 | $0.30
 |  | R8 | 324 kΩ | 1%, 0.125W | SMT | 0805 | RC0805FR-07324KL | 311-324KCRCT-ND | Link (https://www.yageogroup.com/content/datasheet/asset/file/PYU-RC_GROUP_51_ROHS_L) | $0.10 | 1 | $0.10 | 3 | $0.30
 |  | C5 a C6 | 100 nF | 5%, 50V | SMT | 805 | C0805C104J5RACTU | 399-C0805C104J5RACTUCT-ND | Link (https://www.yageogroup.com/content/datasheet/asset/file/KEM_C1002_X7R_SMD) | $0.15 | 2 | $0.30 | 3 | $0.45
 | Pasa bandas 3 | R9 | 6.65 kΩ | 1%, 0.125W | SMT | 0805 | RMCF0805FT6K65 | RMCF0805FT6K65CT-ND | Link (https://www.seielect.com/catalog/SEI-RMCF_RMCP.pdf) | $0.10 | 1 | $0.10 | 3 | $0.30
 |  | R10 | 169 Ω | 1%, 0.125W | SMT | 0805 | RMCF0805FT169R | 738-RMCF0805FT169RCT-ND | Link (https://www.seielect.com/catalog/SEI-RMCF_RMCP.pdf) | $0.10 | 1 | $0.10 | 3 | $0.30
 |  | R11 | 845 kΩ | 1%, 0.125W | SMT | 0805 | ERJ-6ENF8453V | P845KCCT-ND | Link (https://industrial.panasonic.com/cdbs/www-data/pdf/RDA0000/AOA0000C304.pdf) | $0.11 | 1 | $0.11 | 3 | $0.33
 |  | C7 a C8 | 10 nF | 5%, 50V | SMT | 0805 | GRM2195C1H103JA01D | 490-1642-1-ND | Link (https://search.murata.co.jp/Ceramy/image/img/A01X/G101/ENG/GRM2195C1H103JA01-01.pdf) | $0.20 | 2 | $0.40 | 3 | $0.60
 | Pasa bandas 4 | R12 | 1.78 kΩ | 1%, 0.125W | SMT | 0805 | RC0805FR-071K78L | 311-1.78KCRCT-ND | Link (https://www.yageogroup.com/content/datasheet/asset/file/PYU-RC_GROUP_51_ROHS_L) | $0.10 | 1 | $0.10 | 3 | $0.30
 |  | R13 | 37.4 | 1%, 0.125W | SMT | 0805 | RC0805FR-0737R4L | 311-37.4CRCT-ND | Link (https://www.seielect.com/catalog/SEI-RMCF_RMCP.pdf) | $0.10 | 1 | $0.10 | 3 | $0.30
 |  | R14 | 191 kΩ | 1%, 0.125W | SMT | 0805 | RC0805FR-07191KL | 311-191KCRCT-ND | Link (https://www.yageogroup.com/content/datasheet/asset/file/PYU-RC_GROUP_51_ROHS_L) | $0.10 | 1 | $0.10 | 3 | $0.30
 |  | C9 a C10 | 10 nF | 5%, 50V | SMT | 0805 | GRM2195C1H103JA01D | 490-1642-1-ND | Link (https://search.murata.co.jp/Ceramy/image/img/A01X/G101/ENG/GRM2195C1H103JA01-01.pdf) | $0.20 | 2 | $0.40 | 3 | $0.60
 | Pasa altas | R15 | 13.3 kΩ | 1%, 0.125W | SMT | 0805 | RC0805FR-0713K3L | 311-13.3KCRCT-ND | Link (https://www.yageogroup.com/content/datasheet/asset/file/PYU-RC_GROUP_51_ROHS_L) | $0.10 | 1 | $0.10 | 3 | $0.30
 |  | R16 | 6.49 kΩ | 1%, 0.125W | SMT | 0805 | RMCF0805FT6K49 | RMCF0805FT6K49CT-ND | Link (https://www.seielect.com/catalog/SEI-RMCF_RMCP.pdf) | $0.10 | 1 | $0.10 | 3 | $0.30
 |  | C11 | 1.8 nF | 5%, 100V | SMT | 0805 | GRM2165C2A182JA01D | 490-13368-1-ND | Link (https://search.murata.co.jp/Ceramy/image/img/A01X/G101/ENG/GRM2165C2A182JA01-01.pdf) | $0.11 | 1 | $0.11 | 2 | $0.22
 |  | C12 | 1.2 nF | 5%, 100V | SMT | 0805 | GRM2165C2A122JA01D | 490-6446-1-ND | Link (https://search.murata.co.jp/Ceramy/image/img/A01X/G101/ENG/GRM2165C2A122JA01-01.pdf) | $0.10 | 1 | $0.10 | 2 | $0.20
Bloque sumador |  | RV1 a RV6 | 100k |  | THT |  | PTN091-H100115K1B | 2223-PTN091-H100115K1B-ND | Link (https://www.sameskydevices.com/product/resource/ptn09x.pdf) | $1.53 | 6 | $9.18 | 7 | $10.71
 |  | R17 a R22 | 10k | 1%, 0.125W | SMT | 0805 | RT0805BRD0710KL | YAG1763CT-ND | Link (https://www.yageogroup.com/browse/products?search=pyu-rt_1-to-0.01_rohs_l.pdf) | $0.10 | 6 | $0.60 | 7 | $0.70
 |  | R23 | 20k | 0.1%, 0.125W | SMT | 0805 | RT0805BRE0720KL | YAG4970CT-ND | Link (https://www.yageogroup.com/browse/products?search=pyu-rt_1-to-0.01_rohs_l.pdf) | $0.10 | 1 | $0.10 | 2 | $0.20
Extras |  | Test Points |  |  | SMT |  | 5015 | 36-5015CT-ND | Link (https://www.keyelco.com/userAssets/file/M65p55.pdf) | $0.36 | 11 | $3.99 | 13 | $4.72
OPAMPS |  | U3 a U4 |  |  | SMT | SOIC14 | OPA4134UA/2K5 | 296-26284-1-ND | Link (https://www.ti.com/lit/ds/symlink/opa134.pdf?HQS=dis-dk-null-digikeymode-dsf-pf-null-wwe&ts=1762967911606) | $5.88 | 2 | $11.76 | 3 | $17.64
 |  |  |  |  |  |  |  |  |  | TOTAL | 64 | $39.15 | 118 | 60.399
 | POSIBILIDAD | SOLDER PASTE |  |  |  |  | NC191LT10 | 315-NC191LT10-ND |  | $7.95 | 1 | $7.95 | 1
 | V2 | 100k |  | THT |  | PTN091-H100115K1A | 2223-PTN091-H100115K1A-ND | Link (https://www.sameskydevices.com/product/resource/ptn09x.pdf) | $1.53 | 6 | $9.18 | 0 | $0.00

Sheet: Digikey CSV List
TC962COE-ND | 2
2223-PJ-114AH-SMT-TRCT-ND | 2
497-1179-1-ND | 2
399-C0805C334J5RECAUTOCT-ND | 2
399-C0805C104J5RACTUCT-ND | 2
399-18019-1-ND | 3
478-2399-1-ND | 2
CP-3523MJCT-ND | 3
RMCF0805FT1K30CT-ND | 3
311-2.49KCRCT-ND | 3
311-3498-1-ND | 2
13-CC0805JKX7R8BB225CT-ND | 2
311-11.3KCRCT-ND | 3
311-205CRCT-ND | 3
311-1.05MCRCT-ND | 3
399-C0805C104J5RACTUCT-ND | 3
RMCF0805FT4K02CT-ND | 3
738-RMCF0805FT66R5CT-ND | 3
311-324KCRCT-ND | 3
399-C0805C104J5RACTUCT-ND | 3
RMCF0805FT6K65CT-ND | 3
738-RMCF0805FT169RCT-ND | 3
P845KCCT-ND | 3
490-1642-1-ND | 3
311-1.78KCRCT-ND | 3
RMCF0805FT37K4CT-ND | 3
311-191KCRCT-ND | 3
490-1642-1-ND | 3
311-13.3KCRCT-ND | 3
RMCF0805FT6K49CT-ND | 3
490-13368-1-ND | 2
490-6446-1-ND | 2
2223-PTN091-H100115K1B-ND | 7
YAG1763CT-ND | 7
YAG4970CT-ND | 2
36-5015CT-ND | 13
296-26284-1-ND | 3

Sheet: Gastos totales
Digikey componentes | $74.77
PCB | $45.33
Cama Caliente | $78.19
Pasta
Pinzas |  | Pesos | /2
TOTAL | $198.29 | $3569.22 | $1784.61
