gastelumosiel/active-6-band-audio-equalizer-pcb/finaldesign/kicad/project-files/PCB_ProyectoFinal_Ecualizador_V6 (V1.0)/PCB_ProyectoFinal_Ecualizador.step

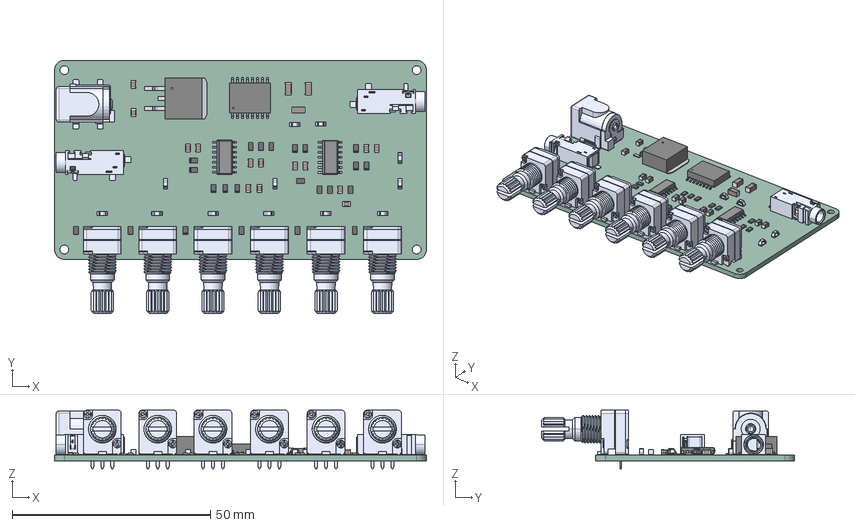
[picture p9: CAD file, 2026-04-21]
finaldesign/kicad/project-files/PCB_ProyectoFinal_Ecualizador_V6 (V1.0)/PCB_ProyectoFinal_Ecualizador.step
93.7 x 63.9 x 14.8 mm
BODY-SO x 2
LEAD-SO x 28
PIN1-ID x 2
BACK_PLATE x 6
PIN_H1 x 12
SECTION-2.5 x 6
FRONT_PLATE x 6
BUSHING_5 x 6
K_SHAFT_L15 x 6
C_0805_2012Metric x 14
R_0805_2012Metric x 23
C_1206_3216Metric x 3
D2PAK_SMD-2L-STD-ST__A_STM
MJ-3523-SMT-TR x 2
PJ-114AH-SMT-TR
SOIC16-W_MC_MCH
PCB_ProyectoFinal_Ecualizador_PCB
