gastelumosiel/active-6-band-audio-equalizer-pcb/prototype/fabrication-notes.pdf

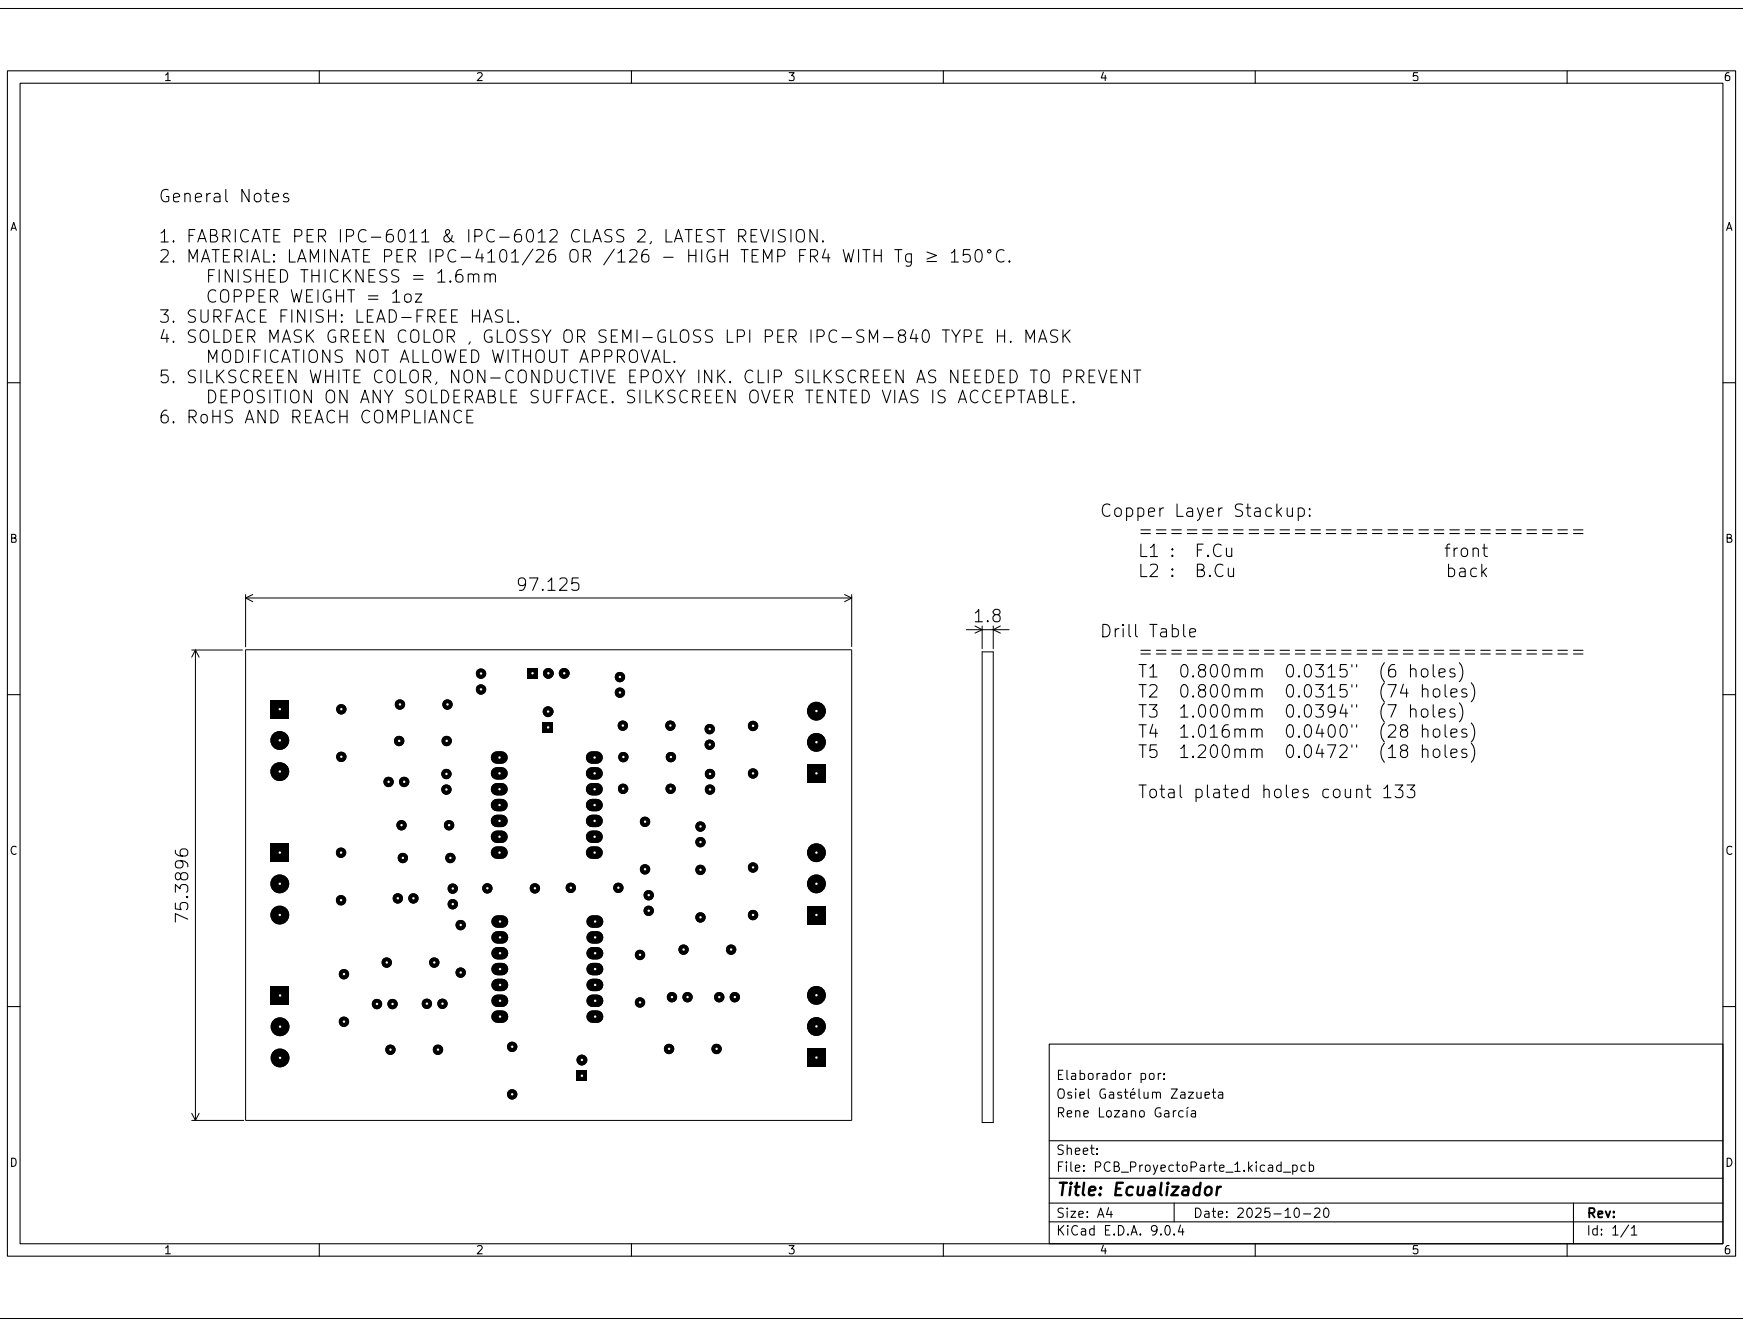
[picture p10: page 1]
