gastelumosiel/active-6-band-audio-equalizer-pcb/prototype/schematic.pdf

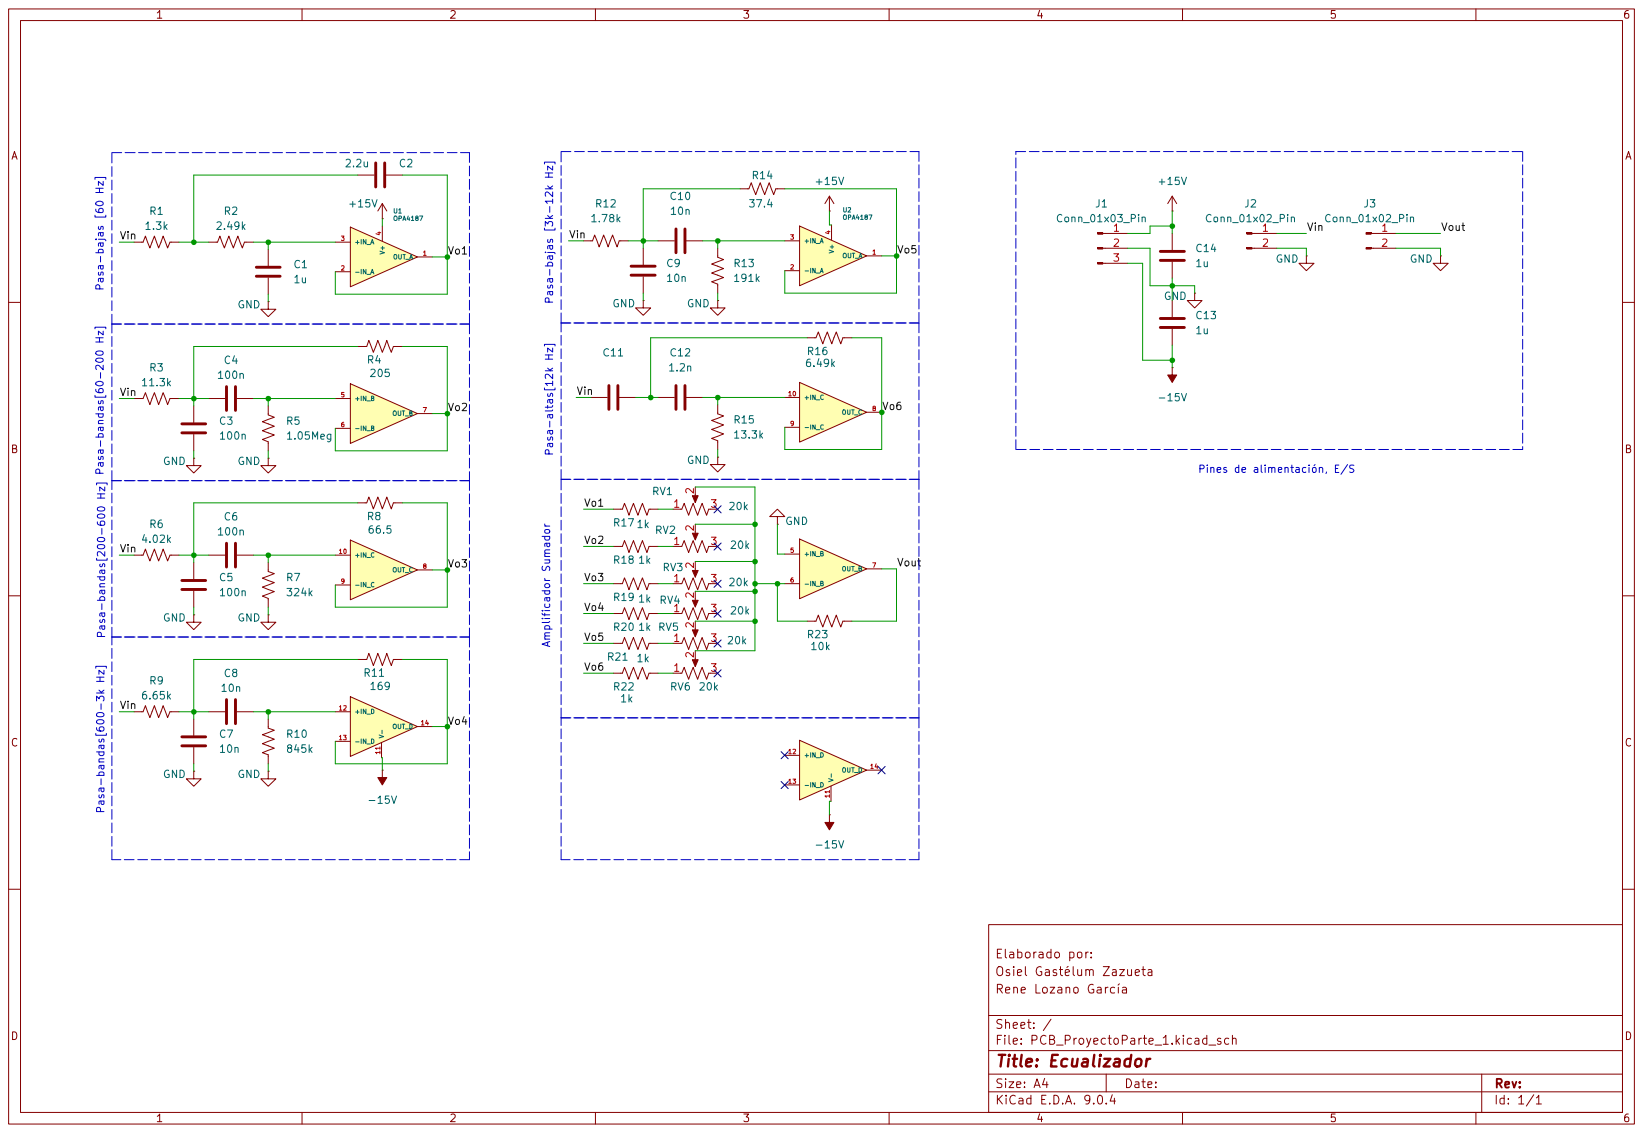
[picture p11: page 1]
