gastelumosiel/active-6-band-audio-equalizer-pcb/finaldesign/kicad/project-files/PCB_ProyectoFinal_Ecualizador_V6 (V1.0)/PCB_ProyectoFinal_Ecualizador.kicad_pcb

## KiCad design finaldesign/kicad/project-files/PCB_ProyectoFinal_Ecualizador_V6 (V1.0)/PCB_ProyectoFinal_Ecualizador.kicad_pcb (2026-04-21)

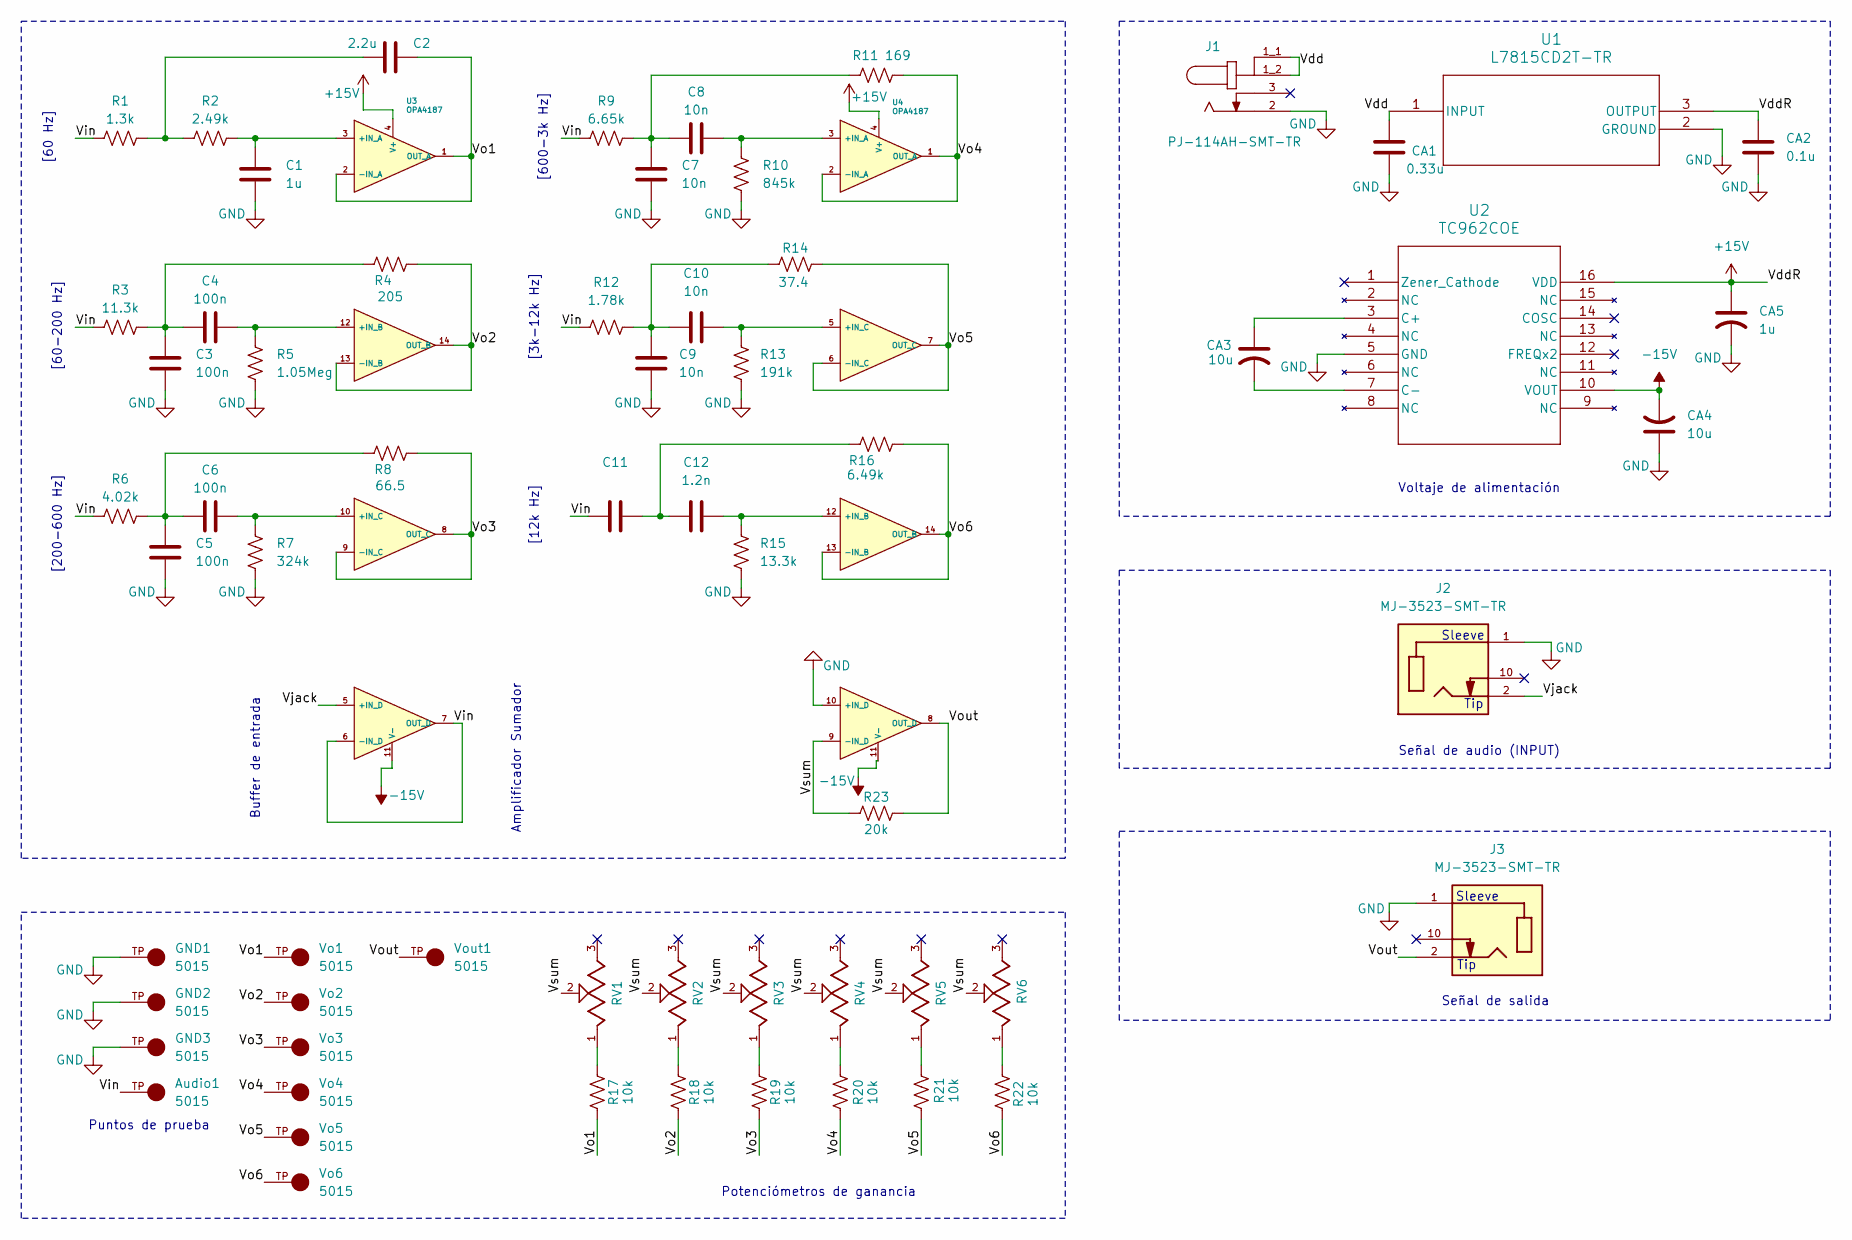
[picture p12: schematic PCB_ProyectoFinal_Ecualizador.kicad_sch, Preamplifier-Equalizer PCB]

Parts:
Audio1: 5015; KEYSTONE_5015; PARTREV F
C1: 1u; C_0805_2012Metric_Pad1.18x1.45mm_HandSolder
C2: 2.2u; C_0805_2012Metric_Pad1.18x1.45mm_HandSolder
C3, C4, C5, C6: 100n; C_0805_2012Metric_Pad1.18x1.45mm_HandSolder
C7, C8, C9, C10: 10n; C_0805_2012Metric_Pad1.18x1.45mm_HandSolder
C11: 1.8n; C_0805_2012Metric_Pad1.18x1.45mm_HandSolder
C12: 1.2n; C_0805_2012Metric_Pad1.18x1.45mm_HandSolder
CA1: 0.33u; C_0805_2012Metric_Pad1.18x1.45mm_HandSolder
CA2: 0.1u; C_0805_2012Metric_Pad1.18x1.45mm_HandSolder
CA3, CA4: 10u; C_1206_3216Metric_Pad1.33x1.80mm_HandSolder_SilkscreenM
CA5: 1u; C_1206_3216Metric_Pad1.33x1.80mm_HandSolder_SilkscreenM
GND1, GND2, GND3: 5015; KEYSTONE_5015; PARTREV F
J1: PJ-114AH-SMT-TR; SAMESKY_PJ-114AH-SMT-TR; PARTREV 1.0
J2, J3: MJ-3523-SMT-TR; CUI_MJ-3523-SMT-TR; PARTREV 1.04
R1: 1.3k; R_0805_2012Metric_Pad1.20x1.40mm_HandSolder
R2: 2.49k; R_0805_2012Metric_Pad1.20x1.40mm_HandSolder
R3: 11.3k; R_0805_2012Metric_Pad1.20x1.40mm_HandSolder
R4: 205; R_0805_2012Metric_Pad1.20x1.40mm_HandSolder
R5: 1.05Meg; R_0805_2012Metric_Pad1.20x1.40mm_HandSolder
R6: 4.02k; R_0805_2012Metric_Pad1.20x1.40mm_HandSolder
R7: 324k; R_0805_2012Metric_Pad1.20x1.40mm_HandSolder
R8: 66.5; R_0805_2012Metric_Pad1.20x1.40mm_HandSolder
R9: 6.65k; R_0805_2012Metric_Pad1.20x1.40mm_HandSolder
R10: 845k; R_0805_2012Metric_Pad1.20x1.40mm_HandSolder
R11: 169; R_0805_2012Metric_Pad1.20x1.40mm_HandSolder
R12: 1.78k; R_0805_2012Metric_Pad1.20x1.40mm_HandSolder
R13: 191k; R_0805_2012Metric_Pad1.20x1.40mm_HandSolder
R14: 37.4; R_0805_2012Metric_Pad1.20x1.40mm_HandSolder
R15: 13.3k; R_0805_2012Metric_Pad1.20x1.40mm_HandSolder
R16: 6.49k; R_0805_2012Metric_Pad1.20x1.40mm_HandSolder
R17, R18, R19, R20, R21, R22: 10k; R_0805_2012Metric_Pad1.20x1.40mm_HandSolder
R23: 20k; R_0805_2012Metric_Pad1.20x1.40mm_HandSolder
RV1, RV2, RV3, RV4, RV5, RV6: PTN091-H100115K1B; TRIM_PTN091-H100115K1B; PARTREV 1.01
U1: L7815CD2T-TR; D2PAKSMD-2L-STD-ST_A_STM
U2: TC962COE; SOIC16-W_MC_MCH
U3, U4: OPA4187; SOIC127P600X175-14N
Vo1, Vo2, Vo3, Vo4, Vo5, Vo6: 5015; KEYSTONE_5015; PARTREV F
Vout1: 5015; KEYSTONE_5015; PARTREV F

Connections:
+15V: CA2.1, CA5.1, U1.3 (OUTPUT), U2.16 (VDD), U3.4 (V+), U4.4 (V+)
-15V: CA4.2, U2.10 (VOUT), U3.11 (V-), U4.11 (V-)
/Vdd: CA1.1, J1.1_1, J1.1_2, U1.1 (INPUT)
/Vin: Audio1.TP, C11.1, R1.1, R3.1, R6.1, R9.1, R12.1, U3.6 (-IN_D), U3.7 (OUT_D); also elsewhere on the board
/Vjack: J2.2, U3.5 (+IN_D)
/Vo1: C2.2, R17.2, U3.1 (OUT_A), U3.2 (-IN_A), Vo1.TP
/Vo2: R4.2, R18.2, U3.13 (-IN_B), U3.14 (OUT_B), Vo2.TP
/Vo3: R8.2, R19.2, U3.8 (OUT_C), U3.9 (-IN_C), Vo3.TP
/Vo4: R11.2, R20.2, U4.1 (OUT_A), U4.2 (-IN_A), Vo4.TP
/Vo5: R14.2, R21.2, U4.6 (-IN_C), U4.7 (OUT_C), Vo5.TP
/Vo6: R16.1, R22.2, U4.13 (-IN_B), U4.14 (OUT_B), Vo6.TP
/Vout: J3.2, R23.1, U4.8 (OUT_D), Vout1.TP; also elsewhere on the board
/Vsum: R23.2, RV1.2, RV2.2, RV3.2, RV4.2, RV5.2, RV6.2, U4.9 (-IN_D)
GND: C1.2, C3.2, C5.2, C7.2, C9.2, CA1.2, CA2.2, CA4.1, CA5.2, GND1.TP, GND2.TP, GND3.TP, J1.2, J2.1, J3.1, R5.1, R7.1, R10.1, R13.1, R15.1, U1.2 (GROUND), U2.5 (GND), U4.10 (+IN_D); also elsewhere on the board
unnamed: C2.1, R1.2, R2.1
unnamed: C3.1, C4.1, R3.2, R4.1
unnamed: C5.1, C6.1, R6.2, R8.1
unnamed: C7.1, C8.1, R9.2, R11.1
unnamed: C9.1, C10.1, R12.2, R14.1
unnamed: C11.2, C12.1, R16.2
unnamed: R17.1, RV1.1
unnamed: R18.1, RV2.1
unnamed: R19.1, RV3.1
unnamed: R20.1, RV4.1
unnamed: R21.1, RV5.1
unnamed: R22.1, RV6.1
unnamed: CA3.1, U2.3 (C+)
unnamed: CA3.2, U2.7 (C-)
unnamed: C1.1, R2.2, U3.3 (+IN_A)
unnamed: C4.2, R5.2, U3.12 (+IN_B)
unnamed: C6.2, R7.2, U3.10 (+IN_C)
unnamed: C8.2, R10.2, U4.3 (+IN_A)
unnamed: C12.2, R15.2, U4.12 (+IN_B)
unnamed: C10.2, R13.2, U4.5 (+IN_C)

Notes on the sheet:
[200-600 Hz]
Sleeve
[12k Hz]
[60-200 Hz]
[600-3k Hz]
Tip
Buffer de entrada
Potenciómetros de ganancia
[60 Hz]
[3k-12k Hz]
Puntos de prueba
Señal de salida
Señal de audio (INPUT)
Voltaje de alimentación
Amplificador Sumador

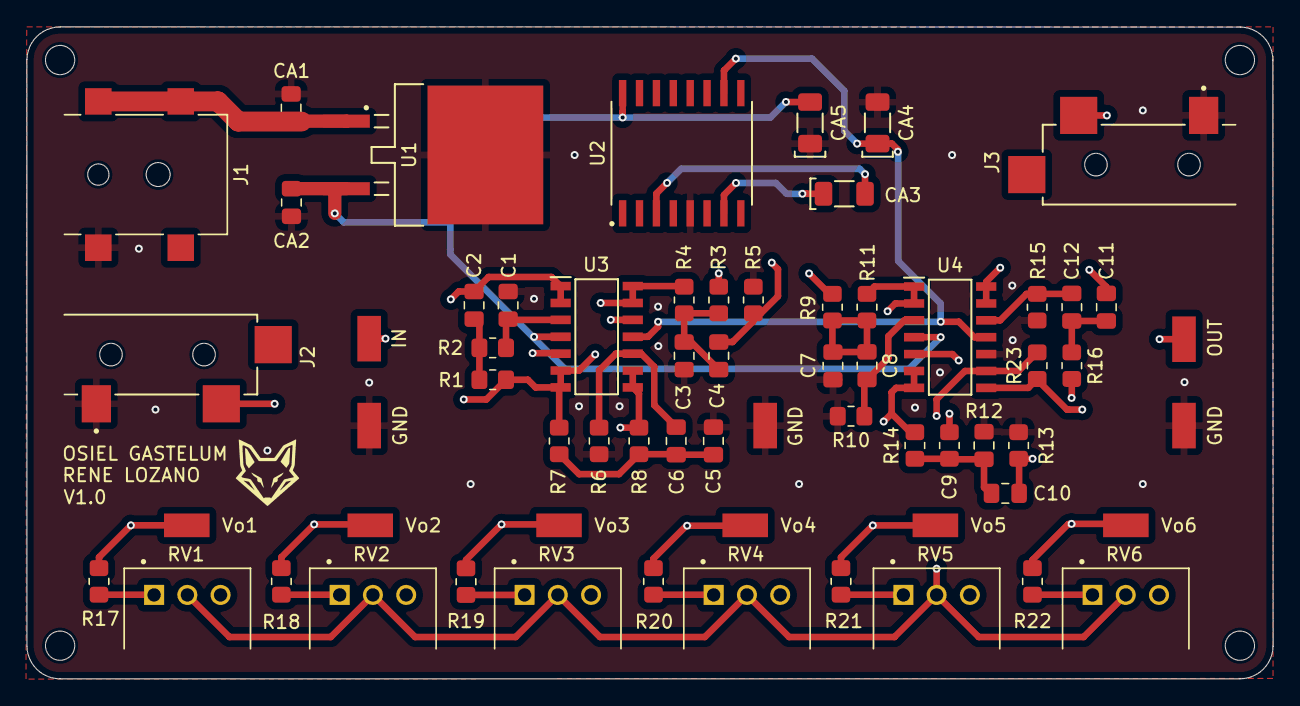
[picture p13: board PCB_ProyectoFinal_Ecualizador.kicad_pcb from above]

Board: 4 copper layers, 93.7 x 49.0 mm, 64 parts (0 on the bottom side), 34 nets.

Other parts of the board:
GND: 5015; KEYSTONE_5015
GND#2, GND#3: 5015; KEYSTONE_5015
IN: 5015; KEYSTONE_5015
OUT: 5015; KEYSTONE_5015

Their connections:
/Vin: IN.TP; also elsewhere on the board
/Vout: OUT.TP; also elsewhere on the board
GND: GND.TP, GND#2.TP, GND#3.TP; also elsewhere on the board
