gastelumosiel/active-6-band-audio-equalizer-pcb/prototype/kicad/project-files/PCB_ProyectoParte_1.kicad_pcb

## KiCad design prototype/kicad/project-files/PCB_ProyectoParte_1.kicad_pcb (2026-04-21)

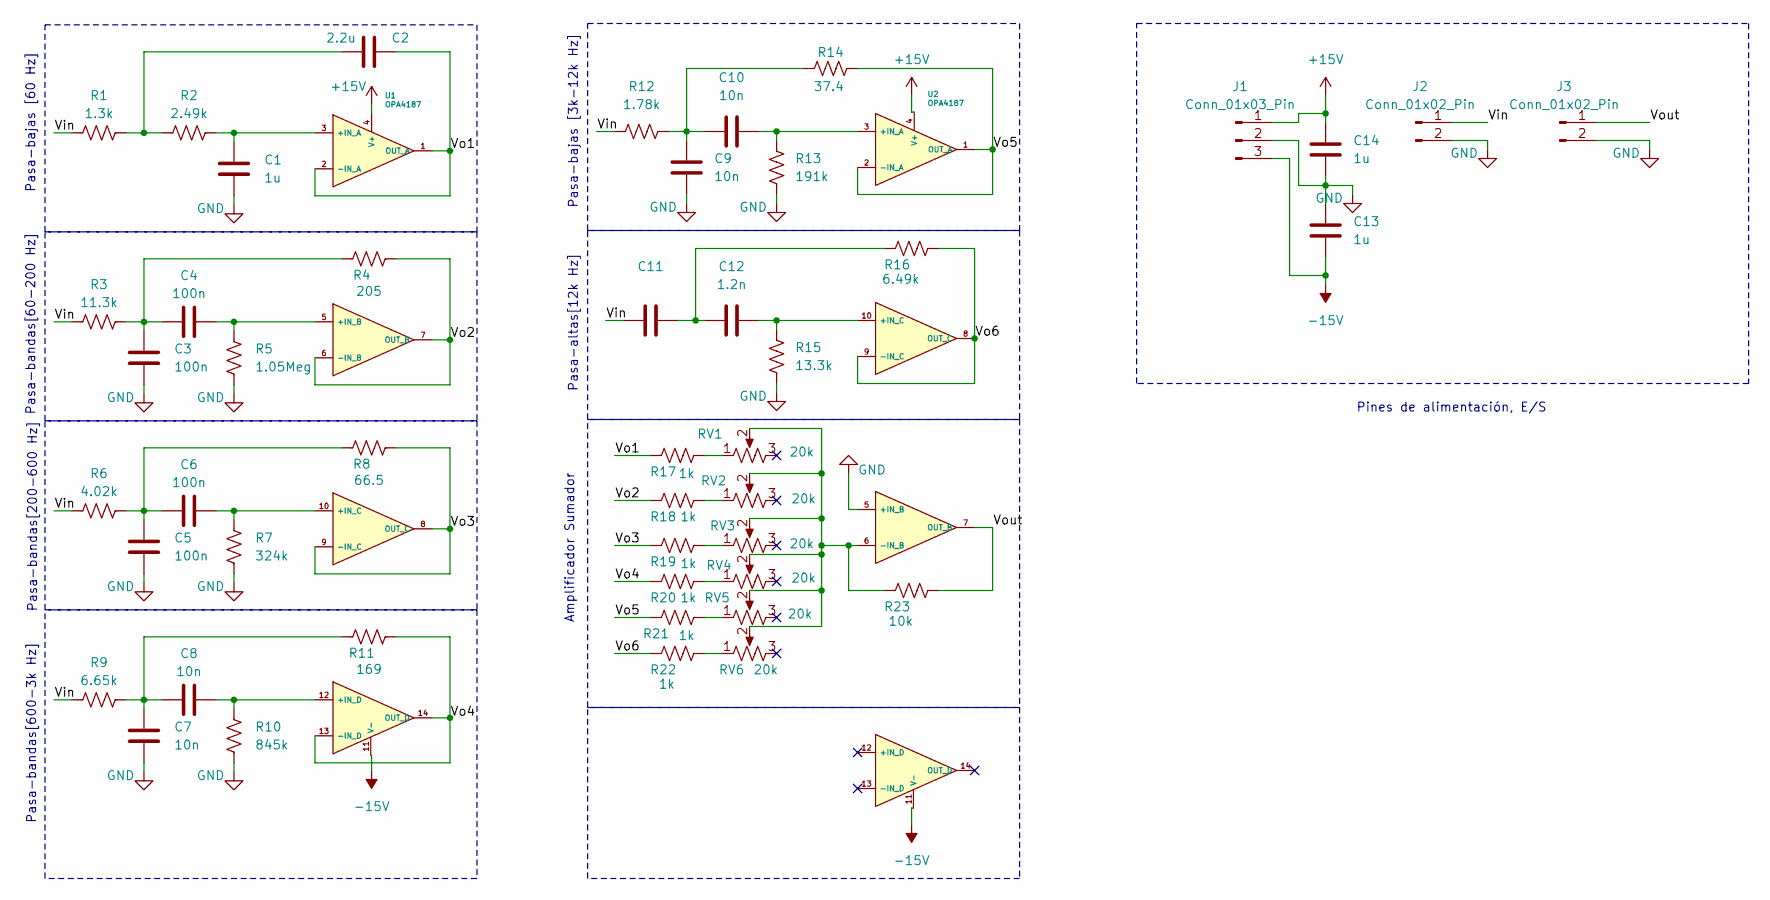
[picture p14: schematic PCB_ProyectoParte_1.kicad_sch]

Parts:
C1, C13, C14: 1u; C_Radial_D6.3mm_H5.0mm_P2.50mm
C2: 2.2u; C_Radial_D6.3mm_H5.0mm_P2.50mm
C3, C4, C5, C6: 100n; C_Radial_D6.3mm_H5.0mm_P2.50mm
C7, C8, C9, C10: 10n; C_Radial_D6.3mm_H5.0mm_P2.50mm
C11: 1.8n; C_Radial_D6.3mm_H5.0mm_P2.50mm
C12: 1.2n; C_Radial_D6.3mm_H5.0mm_P2.50mm
J1: Conn_01x03_Pin; PinHeader_1x03_P2.54mm_Vertical
J2, J3: Conn_01x02_Pin; PinHeader_1x02_P2.54mm_Vertical
R1: 1.3k; R_Axial_DIN0207_L6.3mm_D2.5mm_P7.62mm_Horizontal
R2: 2.49k; R_Axial_DIN0207_L6.3mm_D2.5mm_P7.62mm_Horizontal
R3: 11.3k; R_Axial_DIN0207_L6.3mm_D2.5mm_P7.62mm_Horizontal
R4: 205; R_Axial_DIN0207_L6.3mm_D2.5mm_P7.62mm_Horizontal
R5: 1.05Meg; R_Axial_DIN0207_L6.3mm_D2.5mm_P7.62mm_Horizontal
R6: 4.02k; R_Axial_DIN0207_L6.3mm_D2.5mm_P7.62mm_Horizontal
R7: 324k; R_Axial_DIN0207_L6.3mm_D2.5mm_P7.62mm_Horizontal
R8: 66.5; R_Axial_DIN0207_L6.3mm_D2.5mm_P7.62mm_Horizontal
R9: 6.65k; R_Axial_DIN0207_L6.3mm_D2.5mm_P7.62mm_Horizontal
R10: 845k; R_Axial_DIN0207_L6.3mm_D2.5mm_P7.62mm_Horizontal
R11: 169; R_Axial_DIN0207_L6.3mm_D2.5mm_P7.62mm_Horizontal
R12: 1.78k; R_Axial_DIN0207_L6.3mm_D2.5mm_P7.62mm_Horizontal
R13: 191k; R_Axial_DIN0207_L6.3mm_D2.5mm_P7.62mm_Horizontal
R14: 37.4; R_Axial_DIN0207_L6.3mm_D2.5mm_P7.62mm_Horizontal
R15: 13.3k; R_Axial_DIN0207_L6.3mm_D2.5mm_P7.62mm_Horizontal
R16: 6.49k; R_Axial_DIN0207_L6.3mm_D2.5mm_P7.62mm_Horizontal
R17, R18, R19, R20, R21, R22: 1k; R_Axial_DIN0207_L6.3mm_D2.5mm_P7.62mm_Horizontal
R23: 10k; R_Axial_DIN0207_L6.3mm_D2.5mm_P7.62mm_Horizontal
RV1, RV2, RV3, RV4, RV5, RV6: 20k; Potentiometer_Alps_RK163_Single_Horizontal
U1, U2: OPA4187; SOIC14_LONGPADS

Connections:
+15V: C14.1, J1.1, U1.4 (V+), U2.4 (V+)
-15V: C13.2, J1.3, U1.11 (V-), U2.11 (V-)
/Vin: C11.1, J2.1, R1.1, R3.1, R6.1, R9.1, R12.1
/Vo1: C2.2, R17.2, U1.1 (OUT_A), U1.2 (-IN_A)
/Vo2: R4.2, R18.2, U1.6 (-IN_B), U1.7 (OUT_B)
/Vo3: R8.2, R19.2, U1.8 (OUT_C), U1.9 (-IN_C)
/Vo4: R11.2, R20.2, U1.13 (-IN_D), U1.14 (OUT_D)
/Vo5: R14.2, R21.2, U2.1 (OUT_A), U2.2 (-IN_A)
/Vo6: R16.1, R22.2, U2.8 (OUT_C), U2.9 (-IN_C)
/Vout: J3.1, R23.1, U2.7 (OUT_B)
GND: C1.2, C3.2, C5.2, C7.2, C9.2, C13.1, C14.2, J1.2, J2.2, J3.2, R5.1, R7.1, R10.1, R13.1, R15.1, U2.5 (+IN_B)
unnamed: C2.1, R1.2, R2.1
unnamed: C3.1, C4.1, R3.2, R4.1
unnamed: C5.1, C6.1, R6.2, R8.1
unnamed: C7.1, C8.1, R9.2, R11.1
unnamed: C9.1, C10.1, R12.2, R14.1
unnamed: C11.2, C12.1, R16.2
unnamed: R17.1, RV1.1
unnamed: R18.1, RV2.1
unnamed: R19.1, RV3.1
unnamed: R20.1, RV4.1
unnamed: R21.1, RV5.1
unnamed: R22.1, RV6.1
unnamed: C1.1, R2.2, U1.3 (+IN_A)
unnamed: C4.2, R5.2, U1.5 (+IN_B)
unnamed: C6.2, R7.2, U1.10 (+IN_C)
unnamed: C8.2, R10.2, U1.12 (+IN_D)
unnamed: C10.2, R13.2, U2.3 (+IN_A)
unnamed: C12.2, R15.2, U2.10 (+IN_C)
unnamed: R23.2, RV1.2, RV2.2, RV3.2, RV4.2, RV5.2, RV6.2, U2.6 (-IN_B)

Notes on the sheet:
Pines de alimentación, E/S
Pasa-bandas[60-200 Hz]
Pasa-altas[12k Hz]
Pasa-bandas[200-600 Hz]
Amplificador Sumador
Pasa-bajas [3k-12k Hz]
Pasa-bandas[600-3k Hz]
Pasa-bajas [60 Hz]

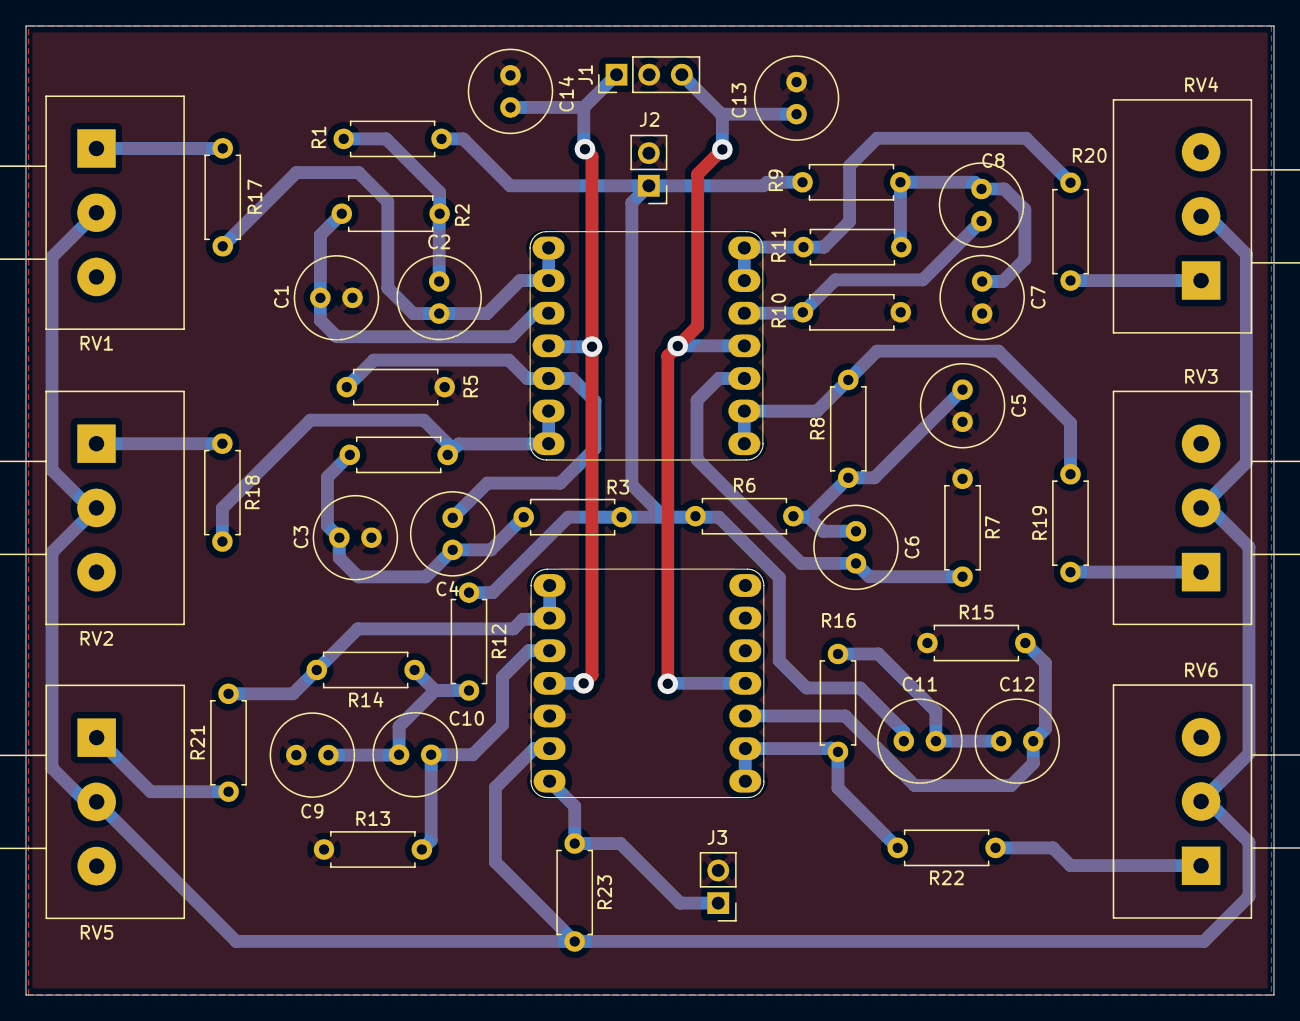
[picture p15: board PCB_ProyectoParte_1.kicad_pcb from above]

Board: 2 copper layers, 97.2 x 75.4 mm, 48 parts (0 on the bottom side), 30 nets.
